ianhyzy/read-remote/FIRMWARE.md

# Read Remote firmware (ZMK)

ZMK config for the Seeed XIAO nRF52840 in the [case](../case/). Two direct-wired buttons, no matrix.

| key | wire | default |
|---|---|---|
| NEXT (big dished cap) | D0 ↔ GND | Page Down |
| PREV (small domed cap) | D1 ↔ GND | Page Up; **hold 5 s = power off** |
| both together | | **hold 1–4 s = travel lock on/off**; **hold 4 s+ = bootloader** |

KOReader turns pages on Page Down / Page Up out of the box. Most other reader apps do too.

## Get the firmware
GitHub Actions builds it on every push to `config/` or `build.yaml`. Open the latest run under **Actions**, download the `firmware` artifact, unzip to get `read_remote.uf2` (and `settings_reset.uf2`).

## Flash
1. Plug in USB-C. Hold **both buttons for 4 s or more**; a `XIAO-SENSE` drive appears. (Fallback, or on a blank board: double-press the reset button through the pinhole.)
2. Drag the `.uf2` onto it. The drive ejects itself and the remote reboots.

Pairings misbehaving? Flash the `settings_reset` artifact the same way, then flash `read_remote` again. That wipes all bonds.

## Pair
On the e-reader, Bluetooth settings → pair **Read Remote**. ZMK keeps up to 5 bonds; it reconnects to the last one.

## Travel lock
The case has a hard power switch (side slider) for travel; that is the normal way to stow it. The firmware lock remains as a backup: hold both buttons for 1–4 s and release, and the buttons are ignored until you do it again. The lock survives sleep and power off.

Why it matters: when the remote is awake and paired, every press sends a key, and a Bluetooth key press will usually wake the e-reader's screen and turn a page. After 30 min idle it deep-sleeps; the first press only wakes it (that press is lost, reconnect takes about a second), and every press after that turns pages again. Power off behaves the same way: any press wakes it. So without the lock, a jostled bag turns pages.

## Power
- Deep sleep after 30 min idle (`CONFIG_ZMK_IDLE_SLEEP_TIMEOUT`); any press wakes it, first press may be swallowed.
- Hold PREV 5 s: full power off. Press either button to wake.
- Battery level appears in the host's Bluetooth device details.

## Change the keymap
- **ZMK Studio** (no rebuild): plug in USB-C, open https://zmk.studio in Chrome, pick the device. Studio is enabled in `build.yaml`.
- Or edit `config/read_remote.keymap` and push; Actions rebuilds.

## Files
- `build.yaml` — which images to build (`read_remote` + `settings_reset`).
- `config/read_remote.keymap`, `config/read_remote.conf` — keymap and settings.
- `boards/shields/read_remote/` — the shield: pins, physical layout, metadata. `zephyr/module.yml` makes the repo a Zephyr module so ZMK finds it.
- `config/west.yml` — pins ZMK v0.3 (on `main` the board id changes to `xiao_ble//zmk`).
