ianhyzy/read-remote/case/renders/bars/base_iso.png

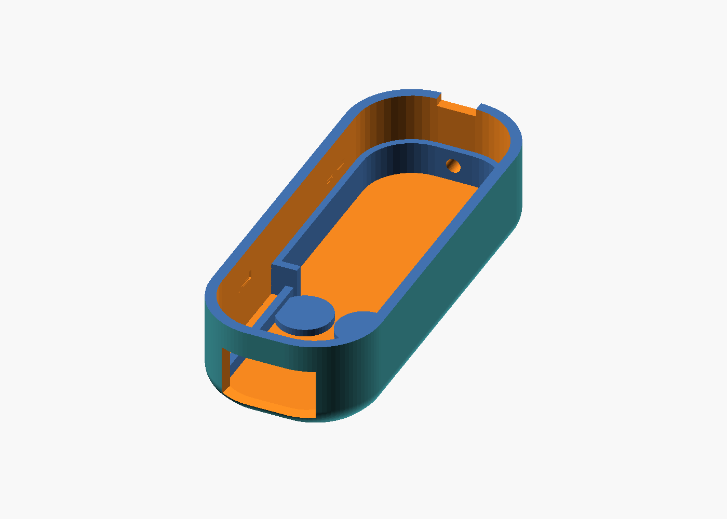
case/renders/bars/base_iso.png
