ianhyzy/read-remote/case/renders/bars/base_usb.png

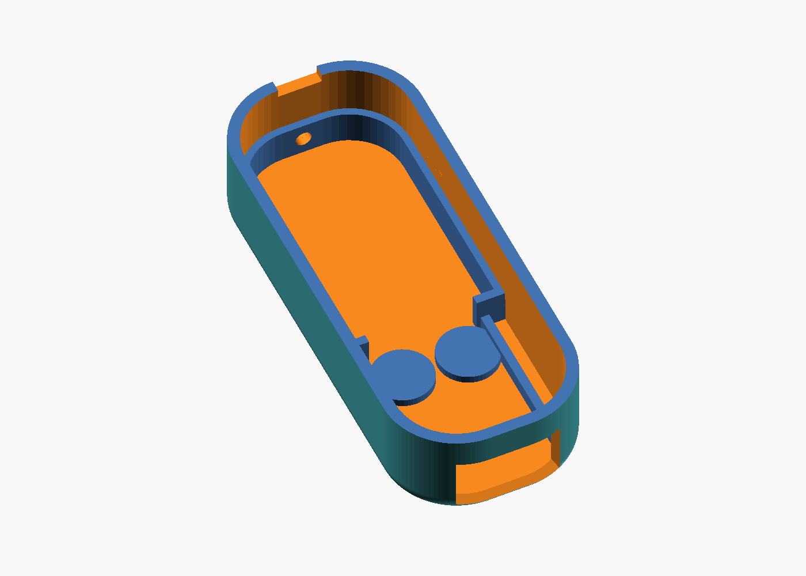
case/renders/bars/base_usb.png
