ianhyzy/read-remote/case/renders/bars/caps.png

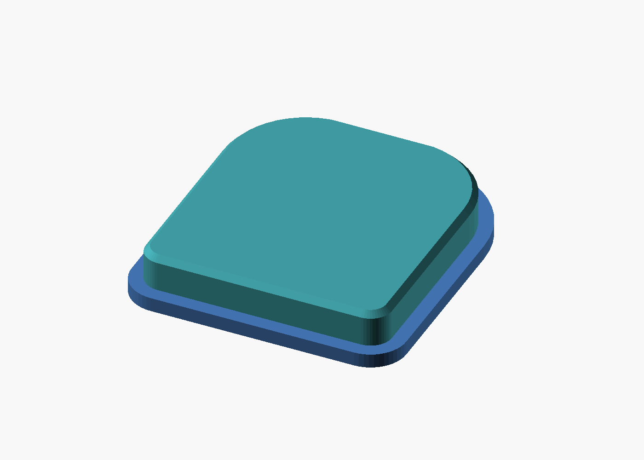
case/renders/bars/caps.png
