ianhyzy/read-remote/case/renders/bars/coupon.png

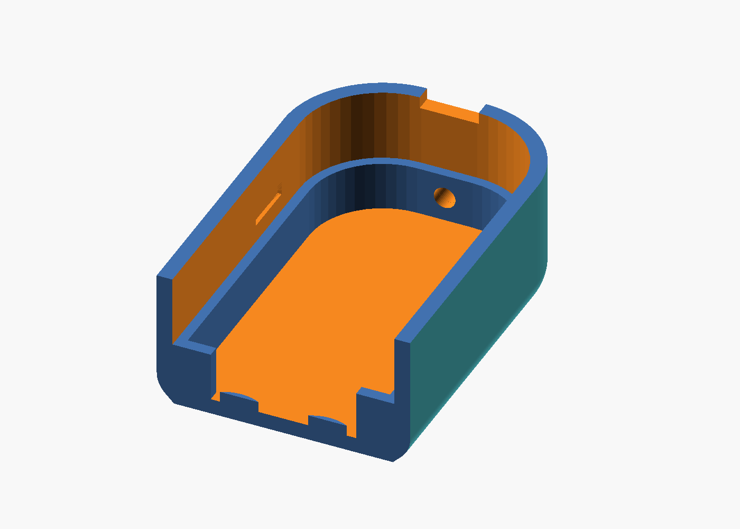
case/renders/bars/coupon.png
