ianhyzy/read-remote/case/renders/bars/exploded.png

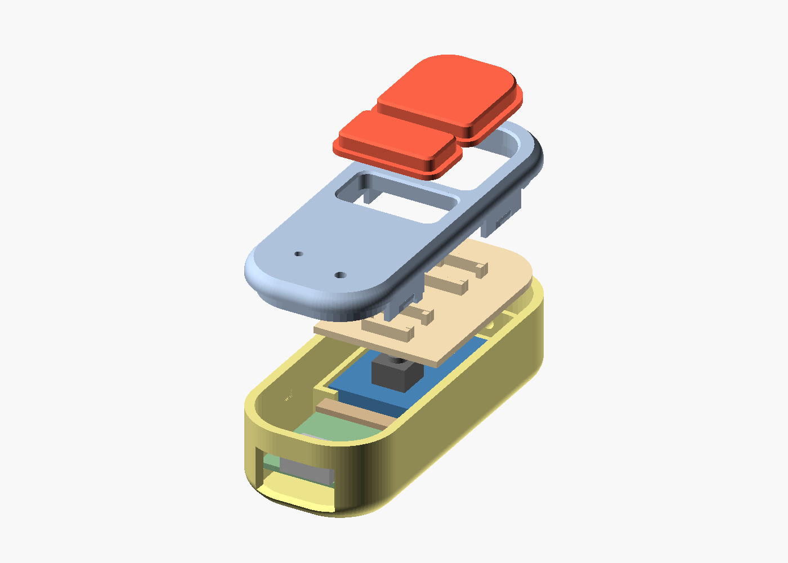
case/renders/bars/exploded.png
