ianhyzy/read-remote/case/renders/bars/lid_under.png

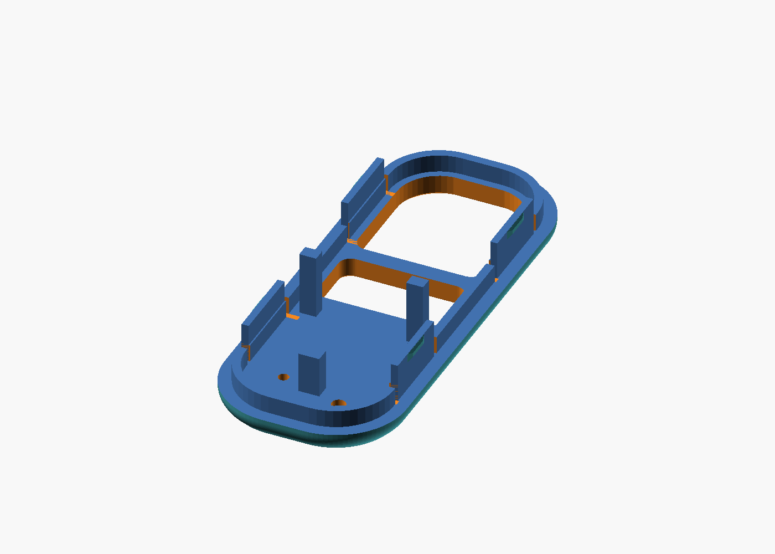
case/renders/bars/lid_under.png
