ianhyzy/read-remote/case/renders/bars/tray.png

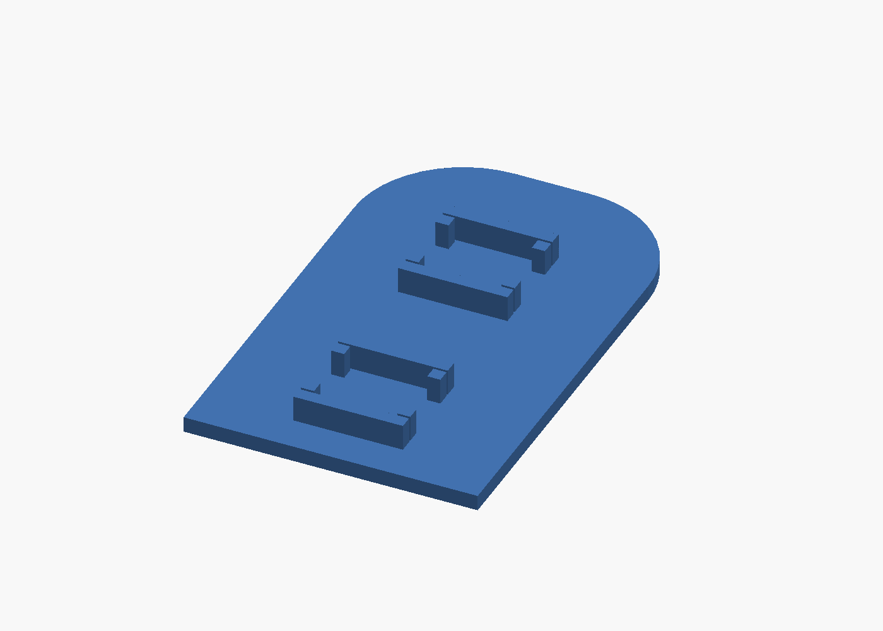
case/renders/bars/tray.png
