ianhyzy/read-remote/case/renders/bars/usb_end.png

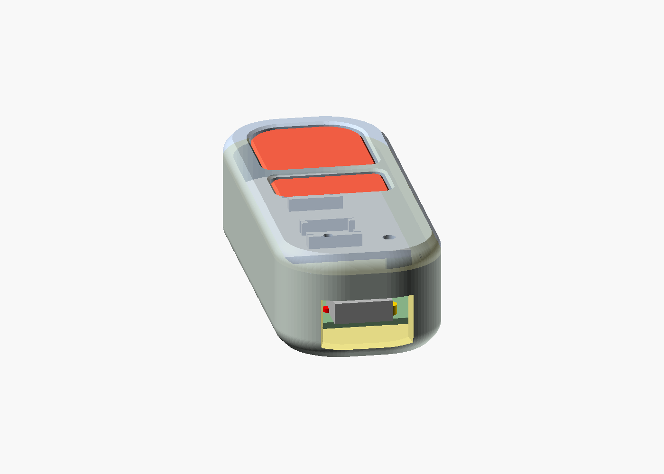
case/renders/bars/usb_end.png
