ianhyzy/read-remote/case/renders/concepts/channel_open.png

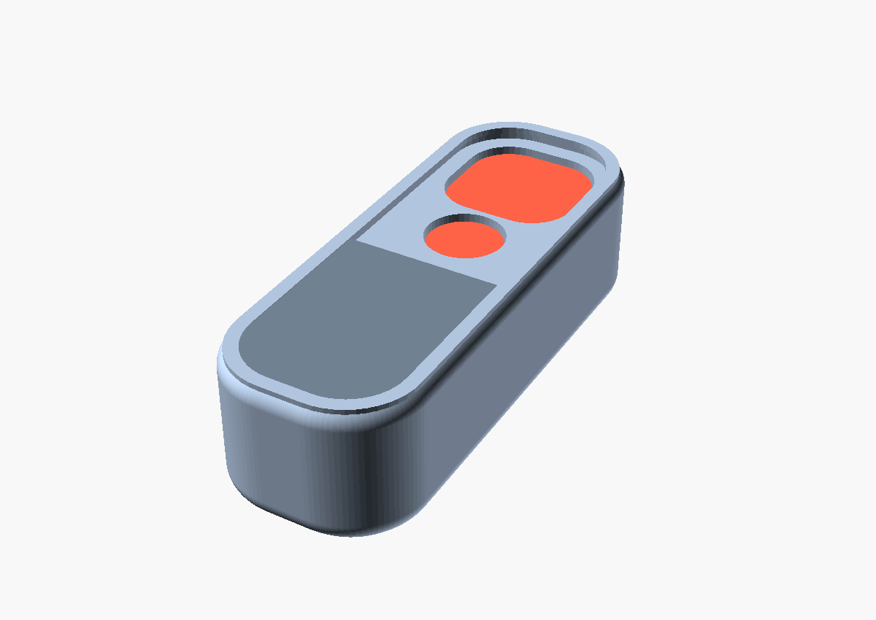
case/renders/concepts/channel_open.png
