ianhyzy/read-remote/case/renders/concepts/pencap_open.png

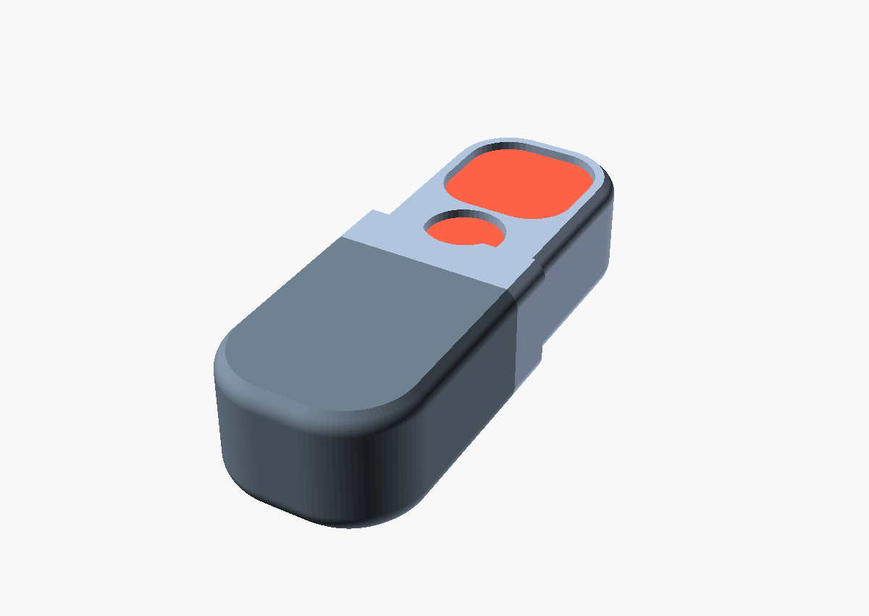
case/renders/concepts/pencap_open.png
