ianhyzy/read-remote/case/renders/dishdome/caps.png

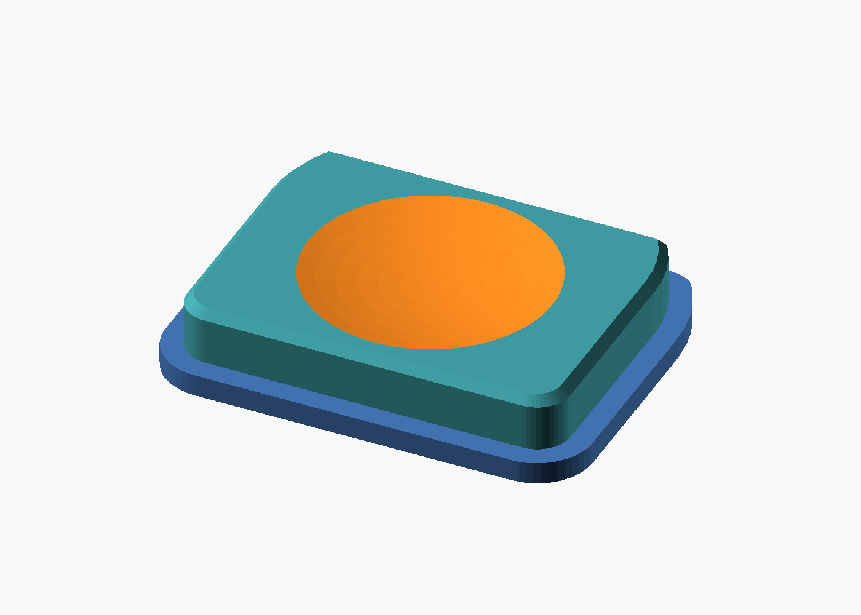
case/renders/dishdome/caps.png
