ianhyzy/read-remote/case/renders/kobo/caps.png

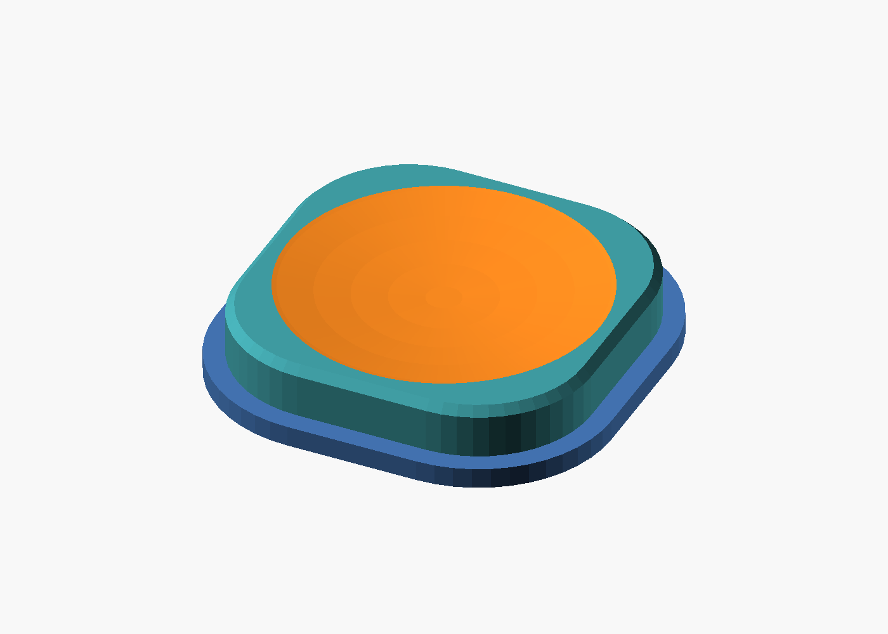
case/renders/kobo/caps.png
