ianhyzy/read-remote/case/renders/kobo/coupon_usb.png

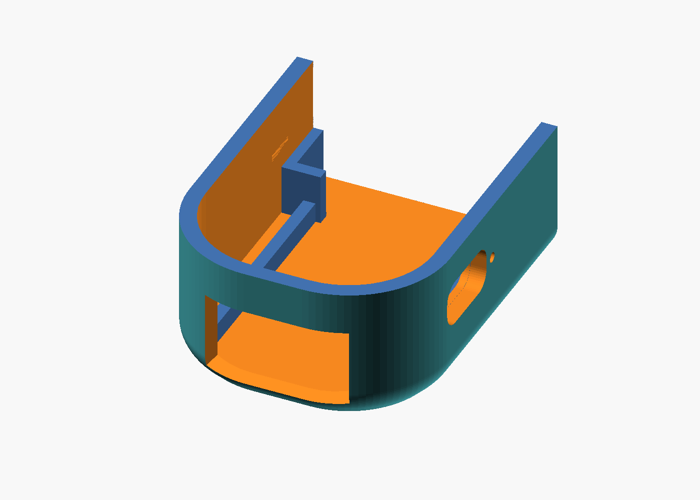
case/renders/kobo/coupon_usb.png
