ianhyzy/read-remote/case/renders/kobo/exploded.png

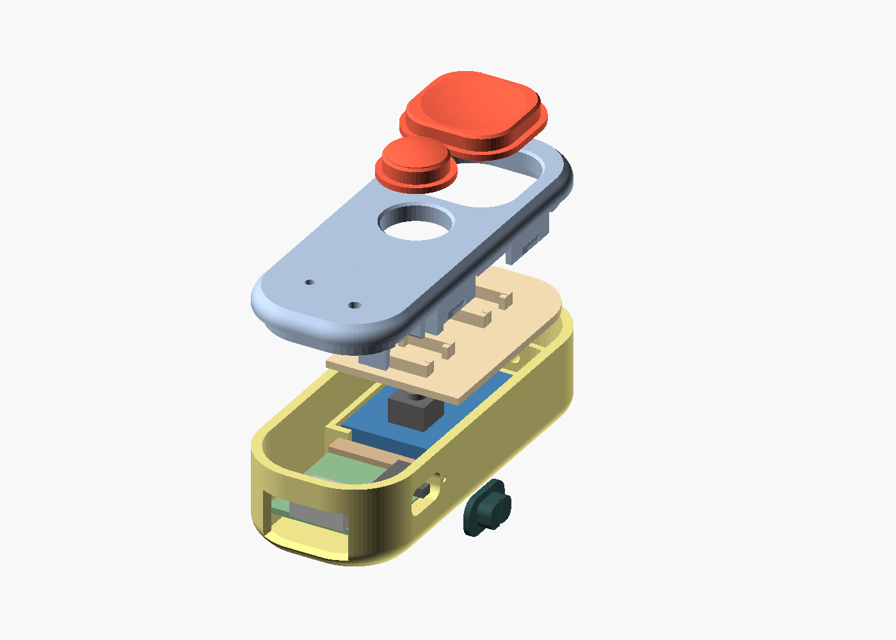
case/renders/kobo/exploded.png
