ianhyzy/read-remote/case/renders/kobo/knob.png

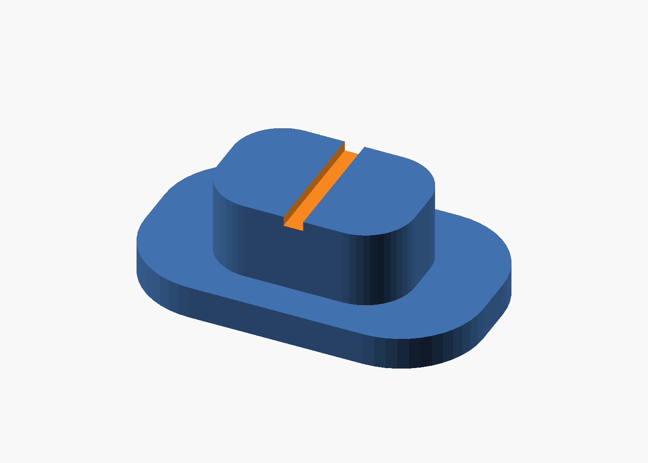
case/renders/kobo/knob.png
