ianhyzy/read-remote/case/renders/kobo/psw_lid.png

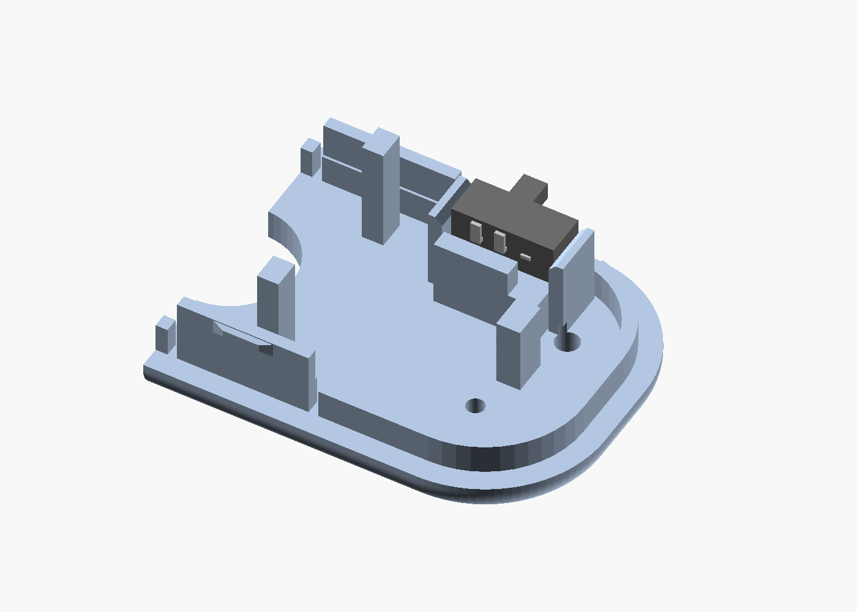
case/renders/kobo/psw_lid.png
