ianhyzy/read-remote/case/renders/kobo/psw_prep.png

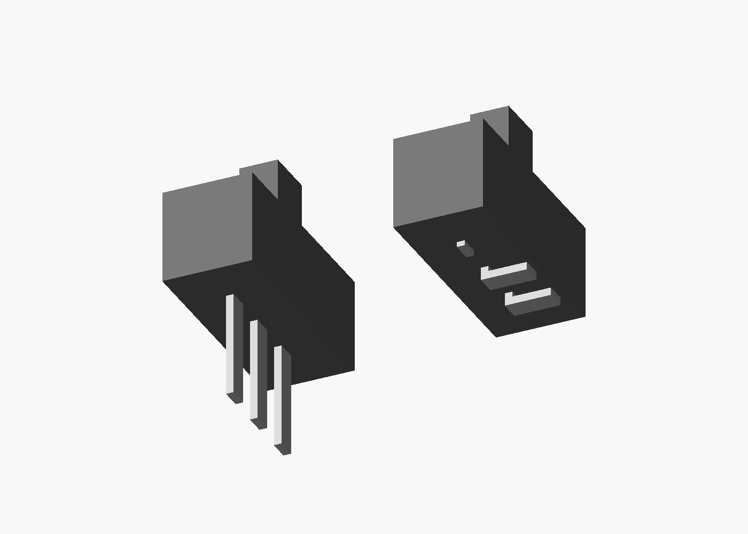
case/renders/kobo/psw_prep.png
