ianhyzy/read-remote/case/renders/kobo/side_iso.png

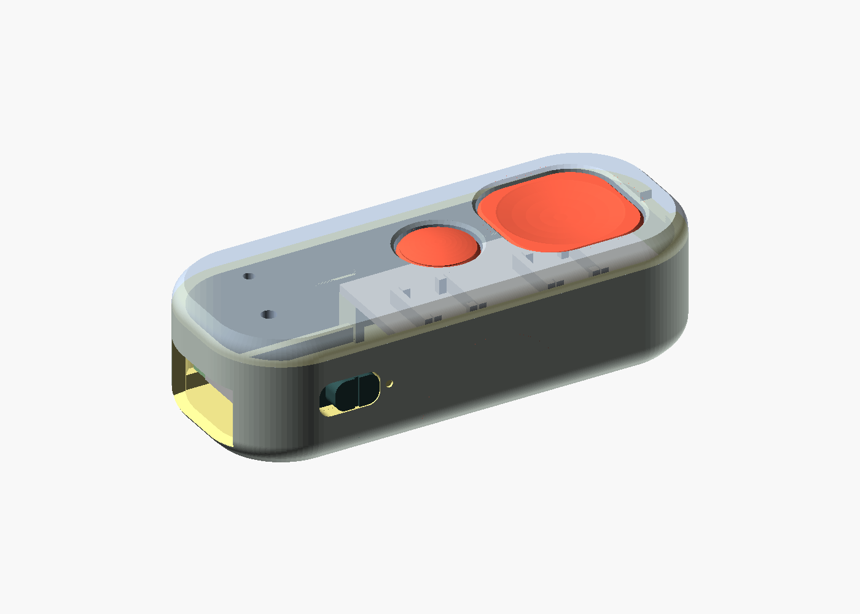
case/renders/kobo/side_iso.png
