ianhyzy/read-remote/case/renders/rocker/caps.png

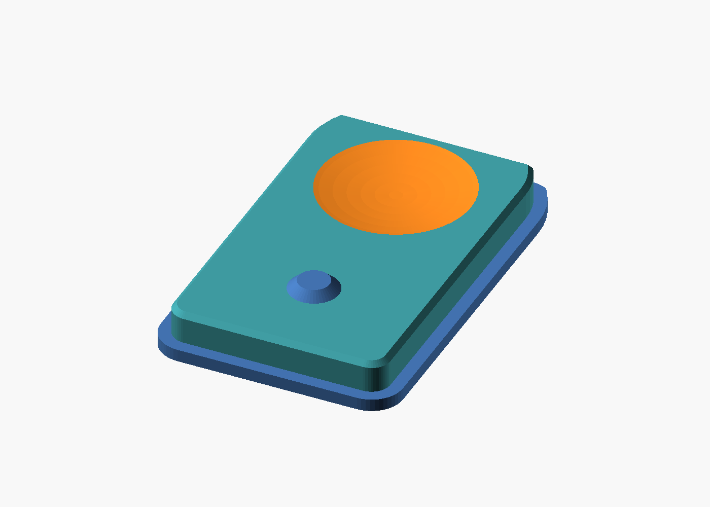
case/renders/rocker/caps.png
