ianhyzy/read-remote/case/renders/rocker/section_mag.png

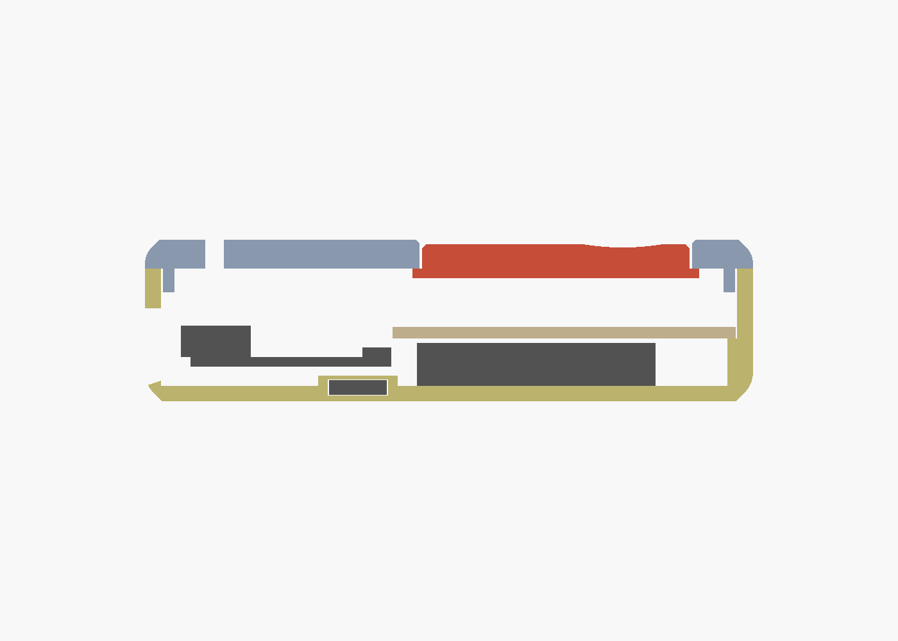
case/renders/rocker/section_mag.png
