ianhyzy/read-remote/case/renders/sidebyside/base_top.png

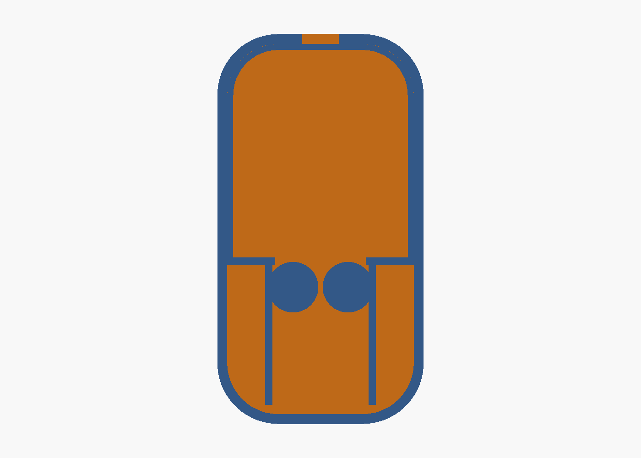
case/renders/sidebyside/base_top.png
