ianhyzy/read-remote/case/renders/sidebyside/base_usb.png

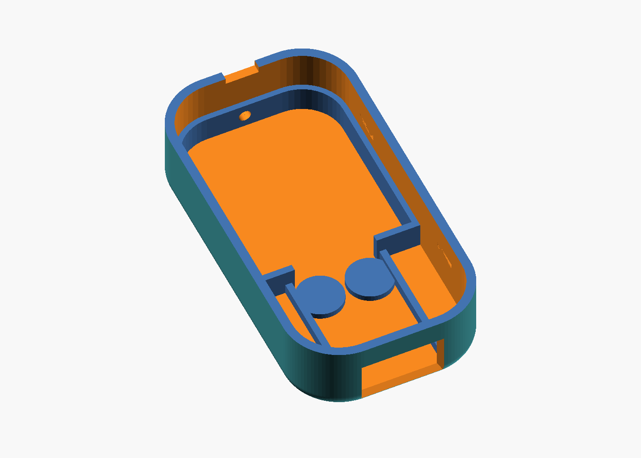
case/renders/sidebyside/base_usb.png
