ianhyzy/read-remote/case/renders/sidebyside/coupon.png

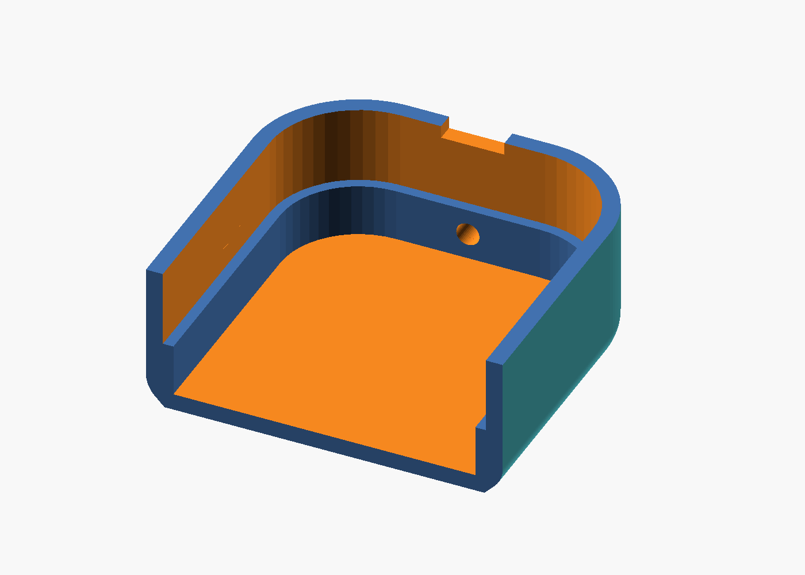
case/renders/sidebyside/coupon.png
