ianhyzy/read-remote/case/renders/sidebyside/exploded.png

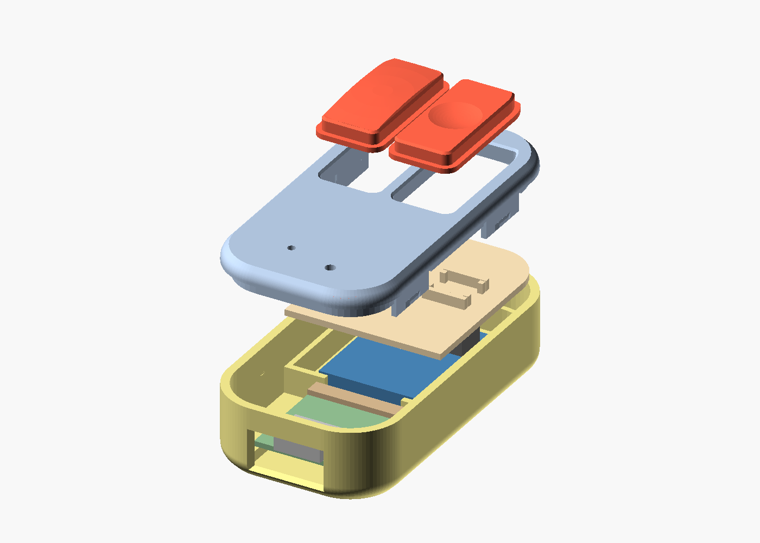
case/renders/sidebyside/exploded.png
