ianhyzy/read-remote/case/renders/sidebyside/lid_under.png

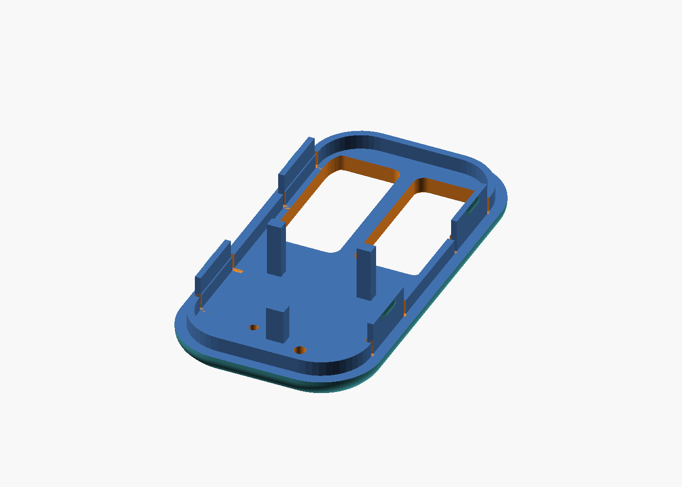
case/renders/sidebyside/lid_under.png
