ianhyzy/read-remote/case/renders/sidebyside/top.png

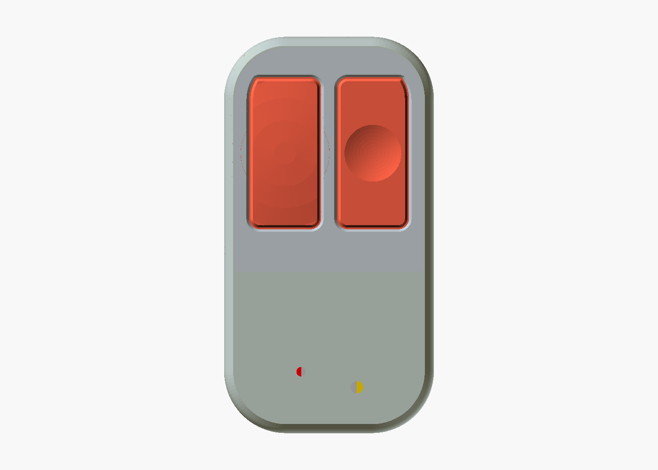
case/renders/sidebyside/top.png
