ianhyzy/read-remote/case/renders/sidebyside/tray.png

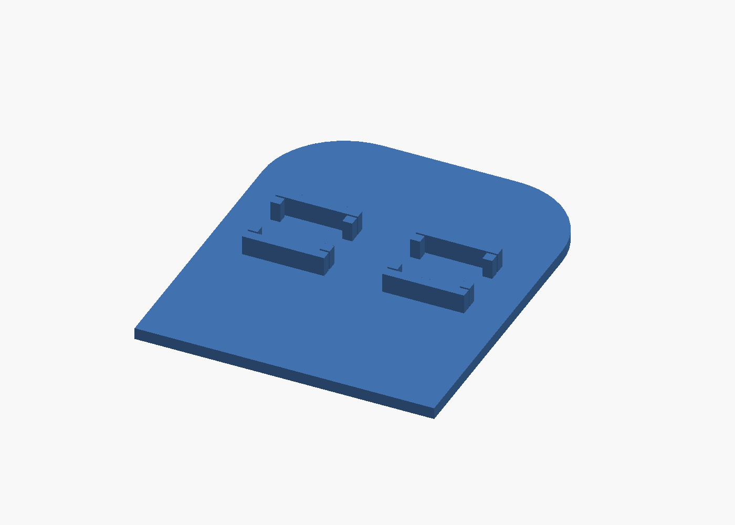
case/renders/sidebyside/tray.png
