ianhyzy/read-remote/case/renders/sidebyside/usb_end.png

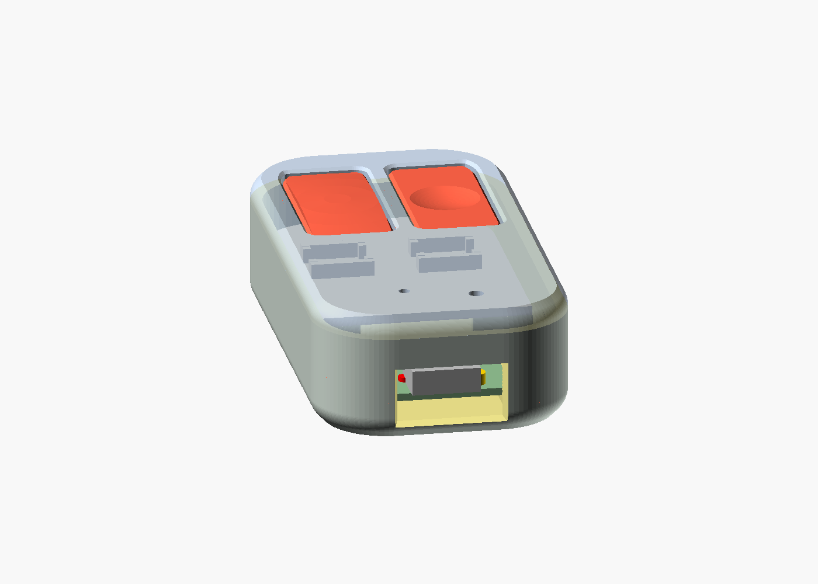
case/renders/sidebyside/usb_end.png
