ianhyzy/read-remote/case/stl/dishdome/coupon_base.stl

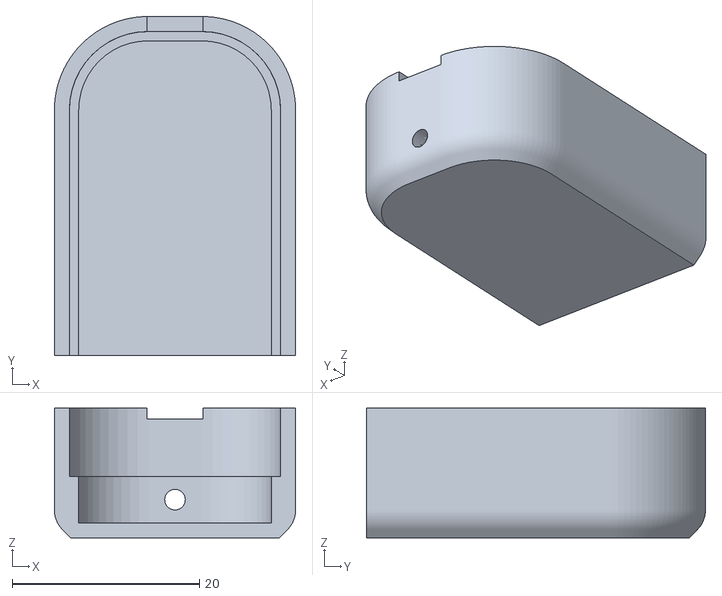
[picture p34: CAD file, 2026-10-19]
case/stl/dishdome/coupon_base.stl
25.8 x 36.2 x 13.9
