ianhyzy/read-remote/case/stl/dot/coupon_tray.stl

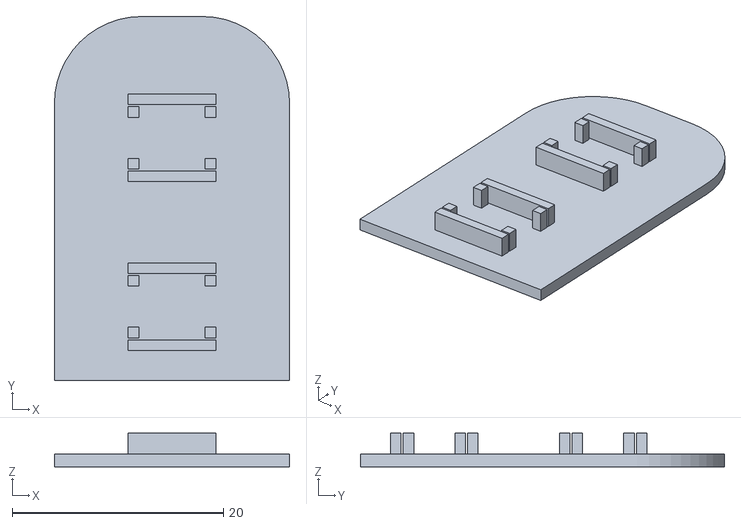
[picture p35: CAD file, 2026-10-19]
case/stl/dot/coupon_tray.stl
22.3 x 34.5 x 3.19
