ianhyzy/read-remote/case/stl/kobo/coupon_base.stl

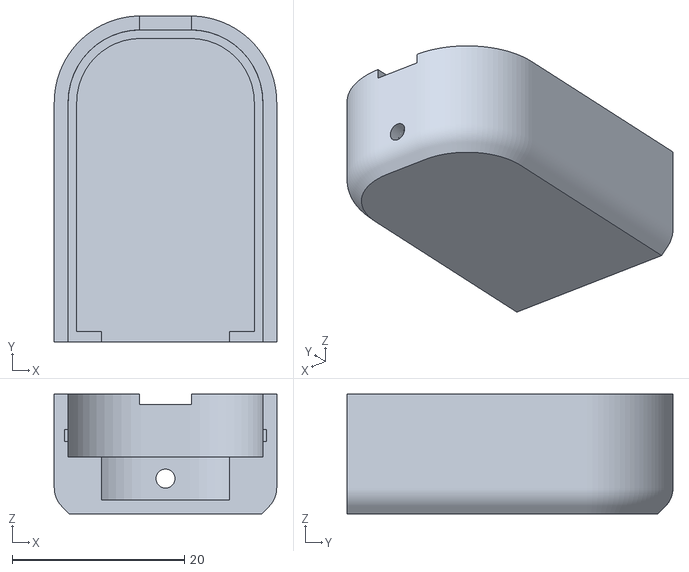
[picture p36: CAD file, 2026-10-31]
case/stl/kobo/coupon_base.stl
25.8 x 37.8 x 13.9
