ianhyzy/read-remote/case/stl/rocker/coupon_base.stl

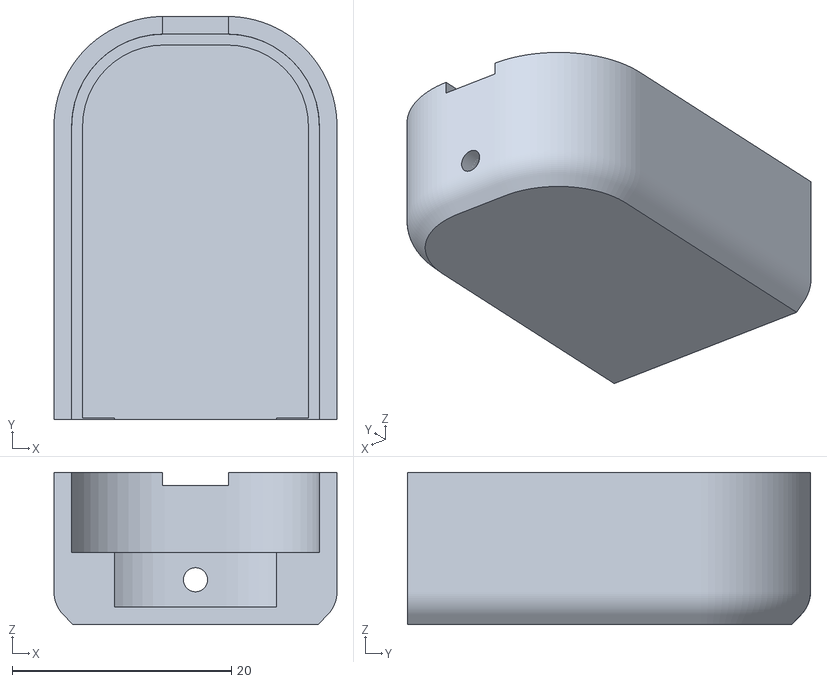
[picture p37: CAD file, 2026-10-19]
case/stl/rocker/coupon_base.stl
25.8 x 36.8 x 13.9
