ianhyzy/read-remote/case/stl/sidebyside/plunger_prev.stl

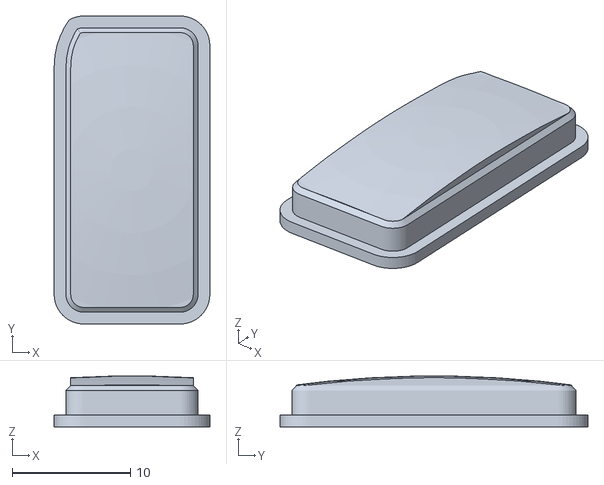
[picture p38: CAD file, 2026-10-19]
case/stl/sidebyside/plunger_prev.stl
13.1 x 26.0 x 4.28
