ianhyzy/read-remote/case/stl/dot/tray.stl

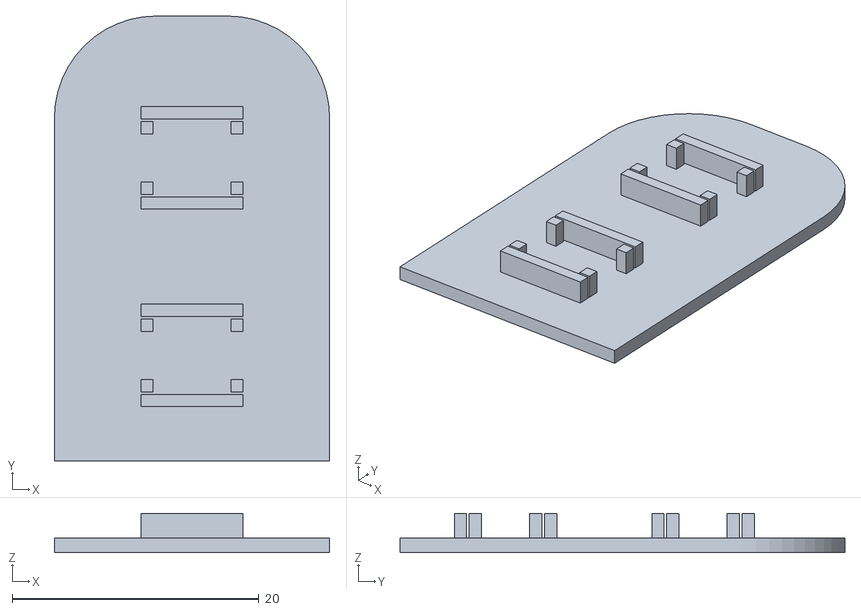
[picture p39: CAD file, 2026-10-19]
case/stl/dot/tray.stl
22.3 x 36.0 x 3.19
