ianhyzy/read-remote/case/stl/kobo/lid.stl

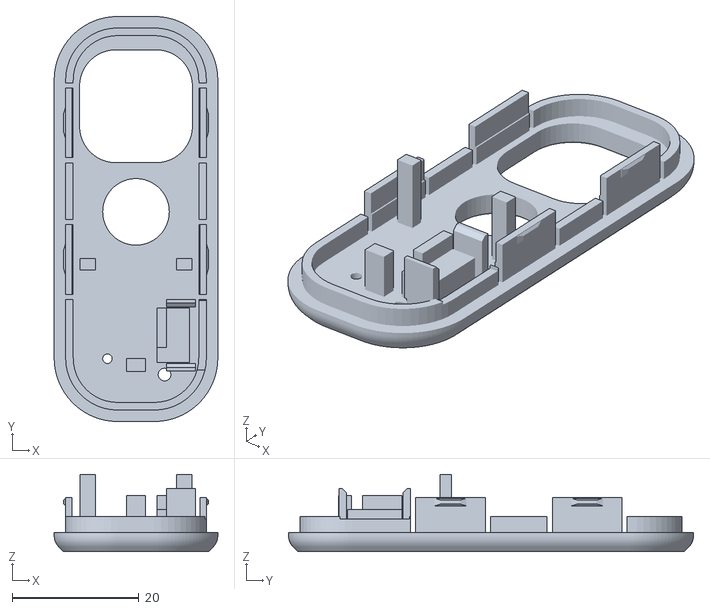
[picture p40: CAD file, 2026-10-31]
case/stl/kobo/lid.stl
25.8 x 63.9 x 12.1
