ianhyzy/read-remote/case/stl/rocker/coupon_lid.stl

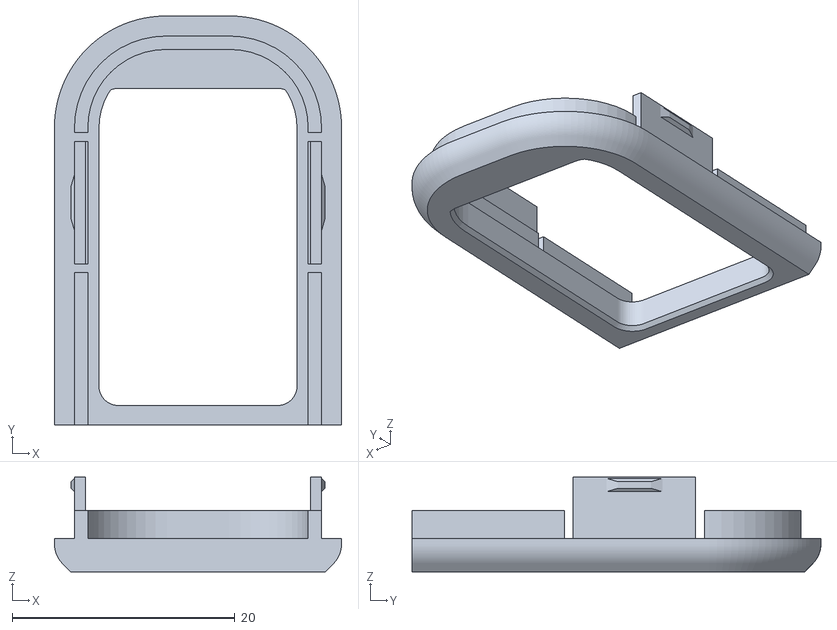
[picture p41: CAD file, 2026-10-19]
case/stl/rocker/coupon_lid.stl
25.8 x 36.8 x 8.50
