ianhyzy/read-remote/case/stl/sidebyside/coupon_lid.stl

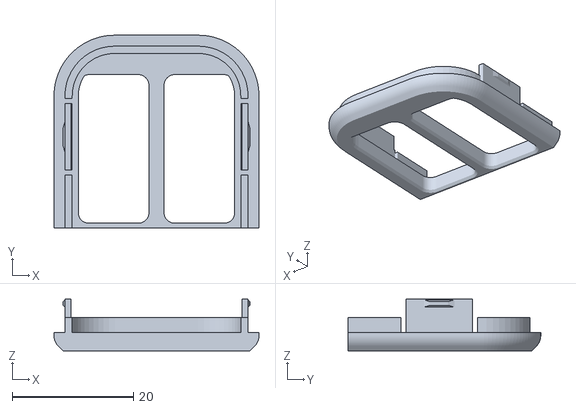
[picture p42: CAD file, 2026-10-19]
case/stl/sidebyside/coupon_lid.stl
33.8 x 31.8 x 8.50
