ianhyzy/read-remote/case/stl/dishdome/lid.stl

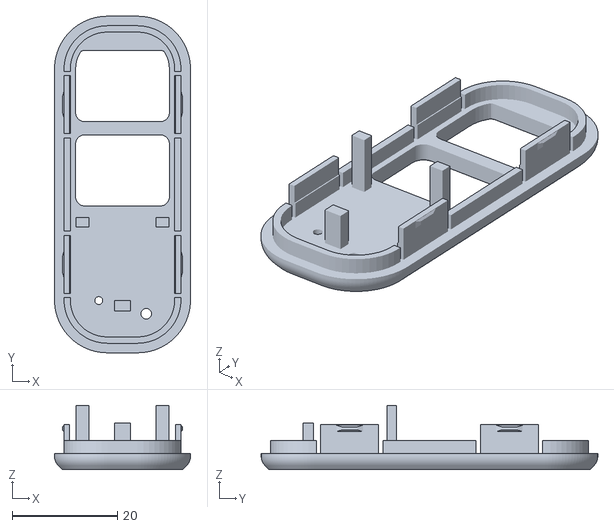
[picture p43: CAD file, 2026-10-19]
case/stl/dishdome/lid.stl
25.8 x 63.9 x 12.1
