ianhyzy/read-remote/case/stl/rocker/plunger_next.stl

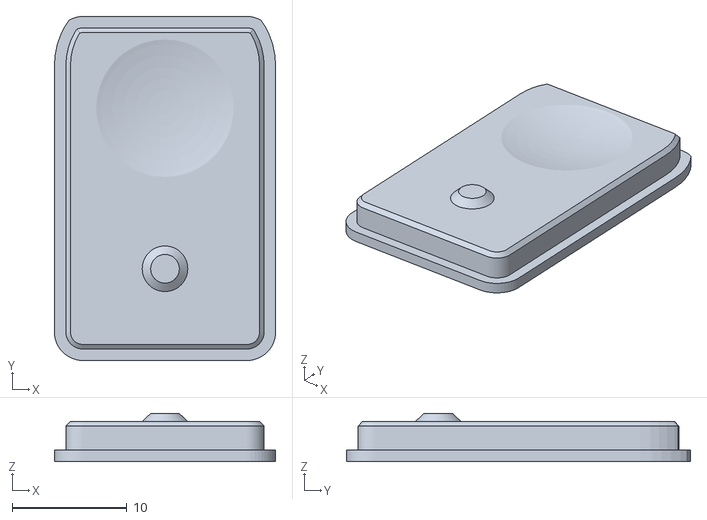
[picture p44: CAD file, 2026-10-19]
case/stl/rocker/plunger_next.stl
19.3 x 30.0 x 4.19
