ianhyzy/read-remote/case/stl/sidebyside/lid.stl

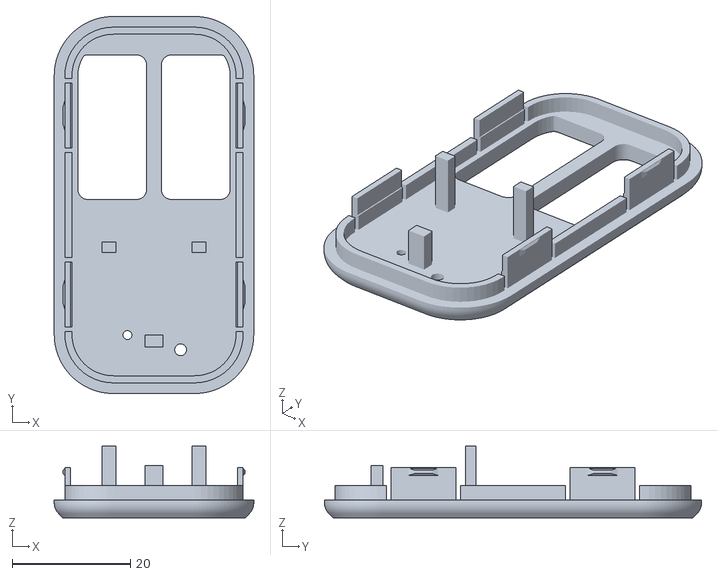
[picture p45: CAD file, 2026-10-19]
case/stl/sidebyside/lid.stl
33.8 x 63.9 x 12.1
