ianhyzy/read-remote/case/stl/dishdome/base.stl

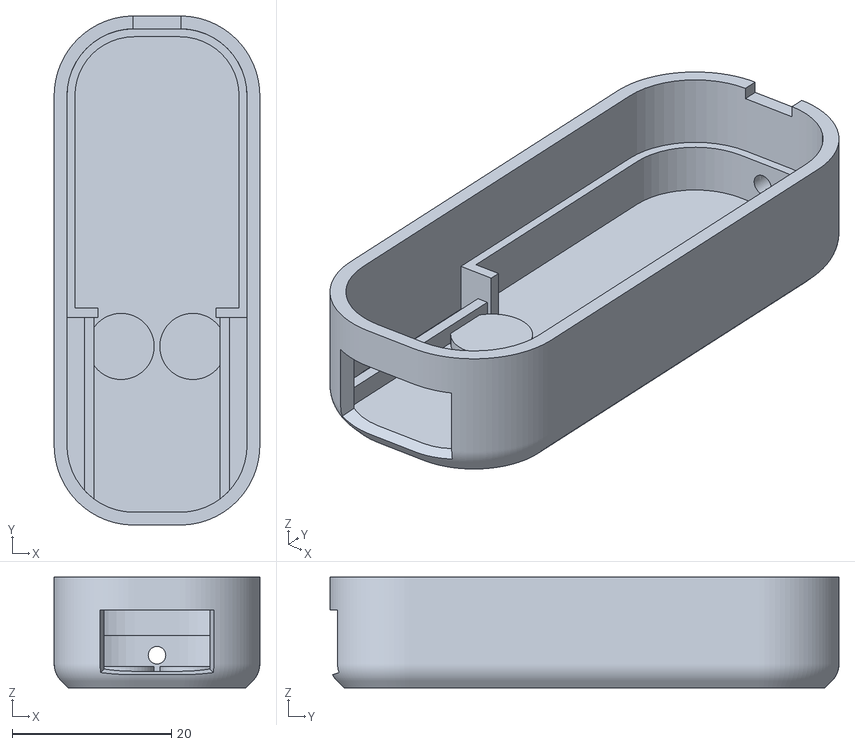
[picture p46: CAD file, 2026-10-19]
case/stl/dishdome/base.stl
25.8 x 63.9 x 13.9
