ianhyzy/read-remote/case/stl/dot/coupon_lid.stl

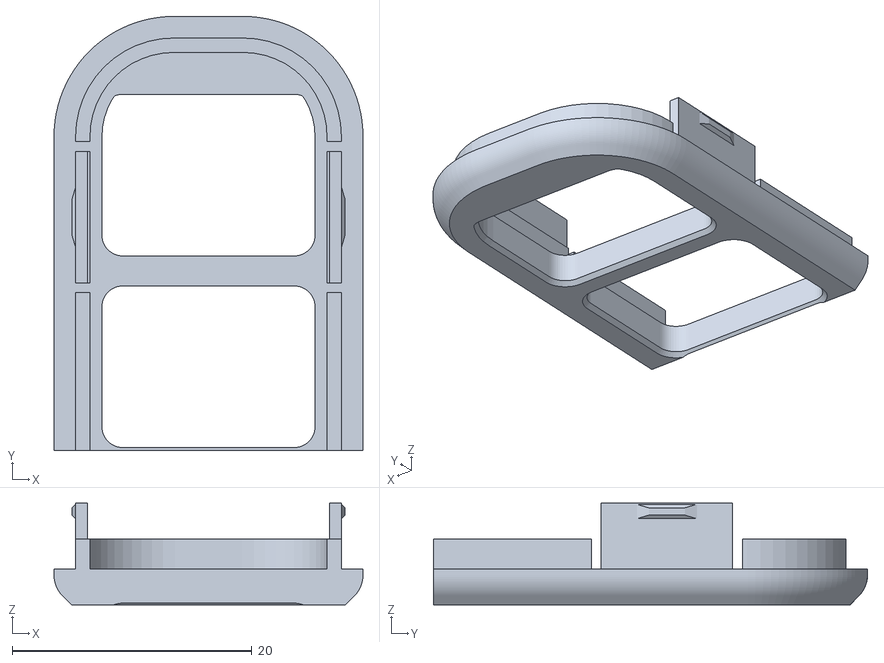
[picture p47: CAD file, 2026-10-19]
case/stl/dot/coupon_lid.stl
25.8 x 36.2 x 8.50
