ianhyzy/read-remote/case/stl/kobo/coupon_usb_lid.stl

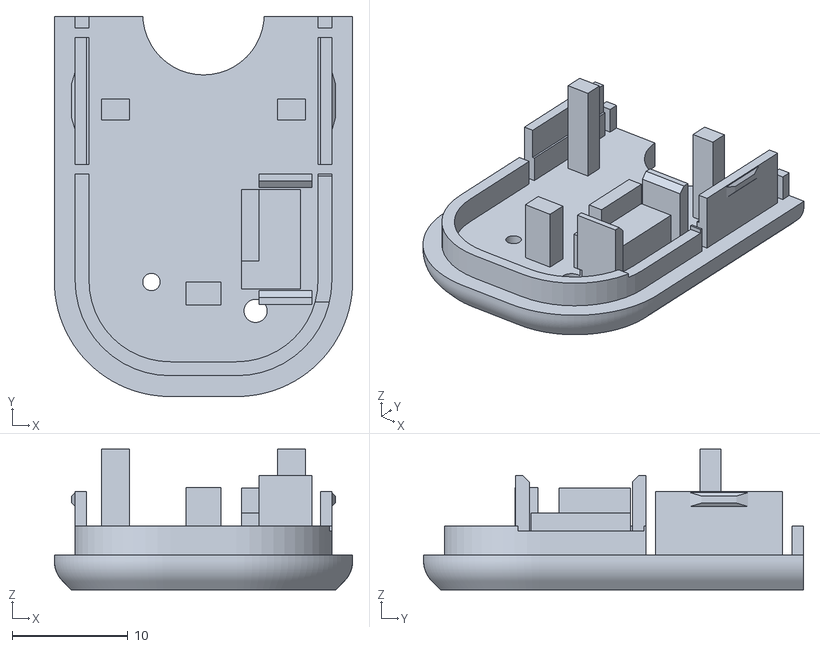
[picture p48: CAD file, 2026-10-31]
case/stl/kobo/coupon_usb_lid.stl
25.8 x 32.9 x 12.1
