ianhyzy/read-remote/case/stl/rocker/lid.stl

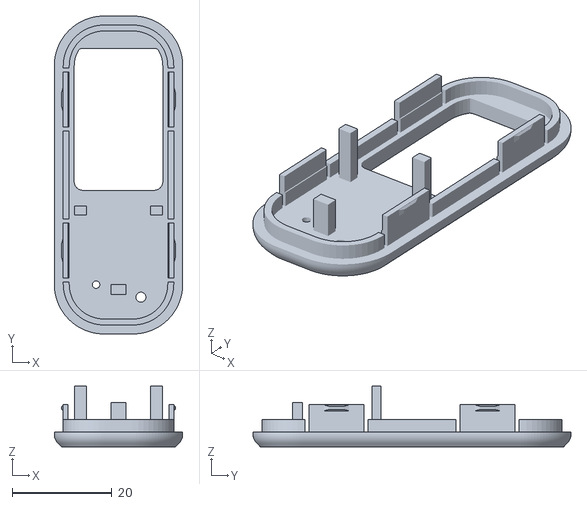
[picture p49: CAD file, 2026-10-19]
case/stl/rocker/lid.stl
25.8 x 63.9 x 12.1
