ianhyzy/read-remote/case/stl/sidebyside/coupon_tray.stl

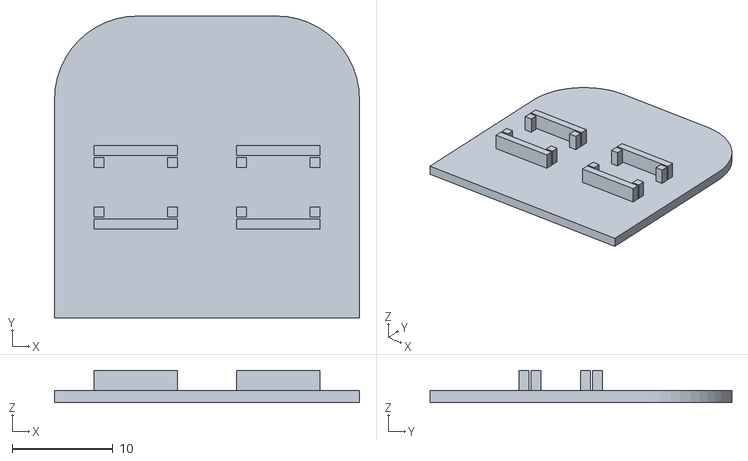
[picture p50: CAD file, 2026-10-19]
case/stl/sidebyside/coupon_tray.stl
30.3 x 30.0 x 3.19
