ianhyzy/read-remote/case/stl/dishdome/plunger_next.stl

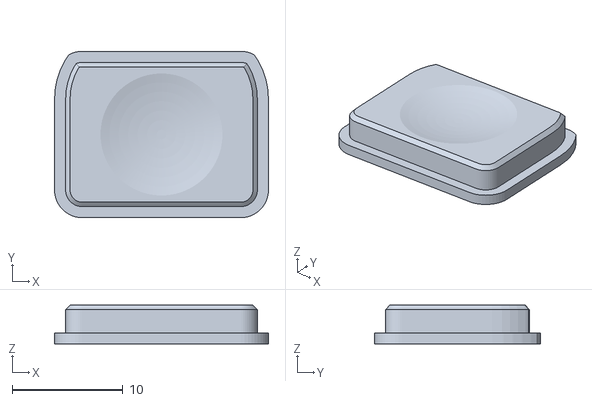
[picture p51: CAD file, 2026-10-19]
case/stl/dishdome/plunger_next.stl
19.3 x 15.0 x 3.50
