ianhyzy/read-remote/case/stl/kobo/coupon_usb_base.stl

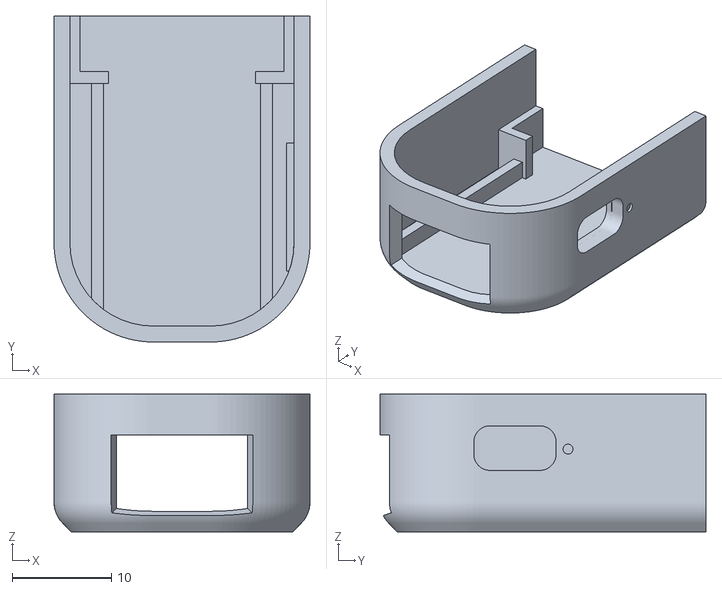
[picture p52: CAD file, 2026-10-31]
case/stl/kobo/coupon_usb_base.stl
25.8 x 32.9 x 13.9
