ianhyzy/read-remote/case/stl/rocker/coupon_tray.stl

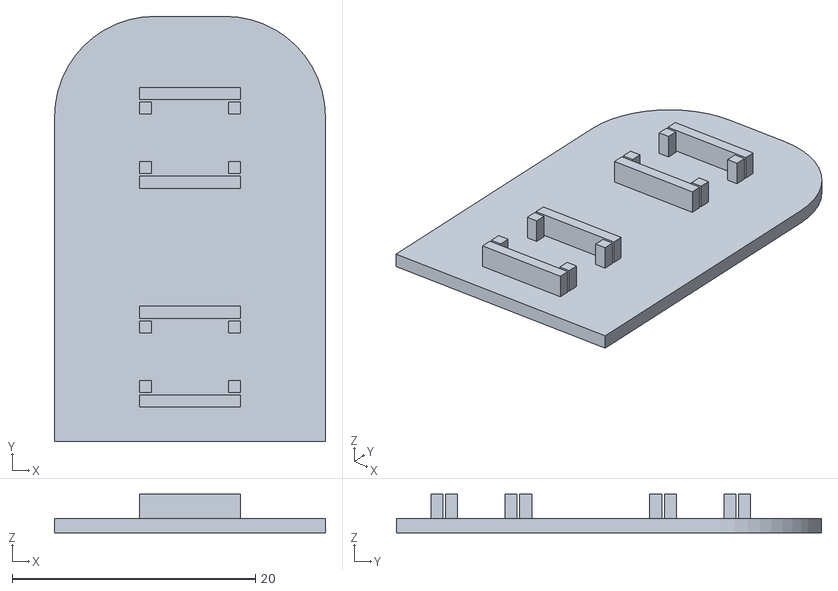
[picture p53: CAD file, 2026-10-19]
case/stl/rocker/coupon_tray.stl
22.3 x 35.0 x 3.19
