ianhyzy/read-remote/case/stl/sidebyside/plunger_next.stl

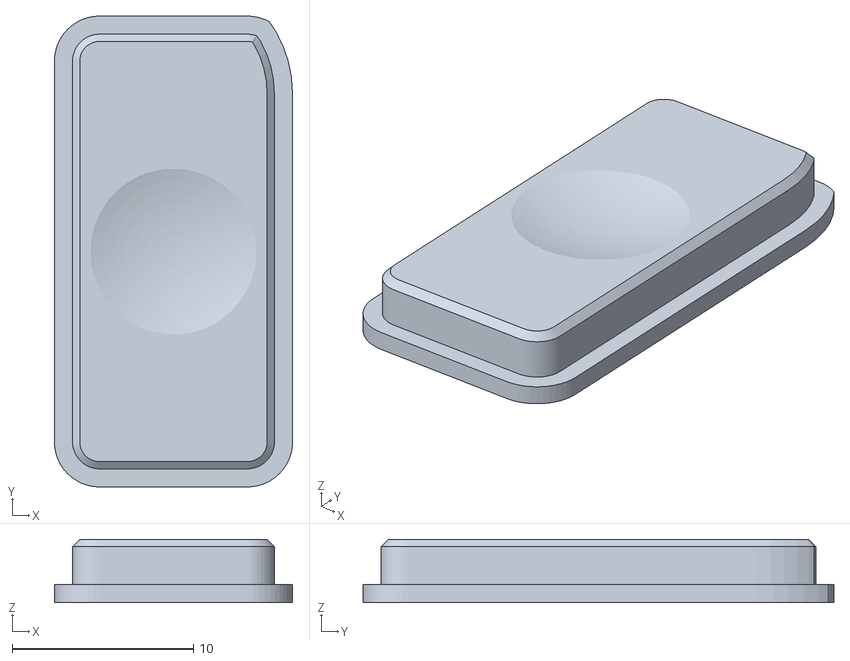
[picture p54: CAD file, 2026-10-19]
case/stl/sidebyside/plunger_next.stl
13.1 x 26.0 x 3.50
