ianhyzy/read-remote/case/stl/sidebyside/tray.stl

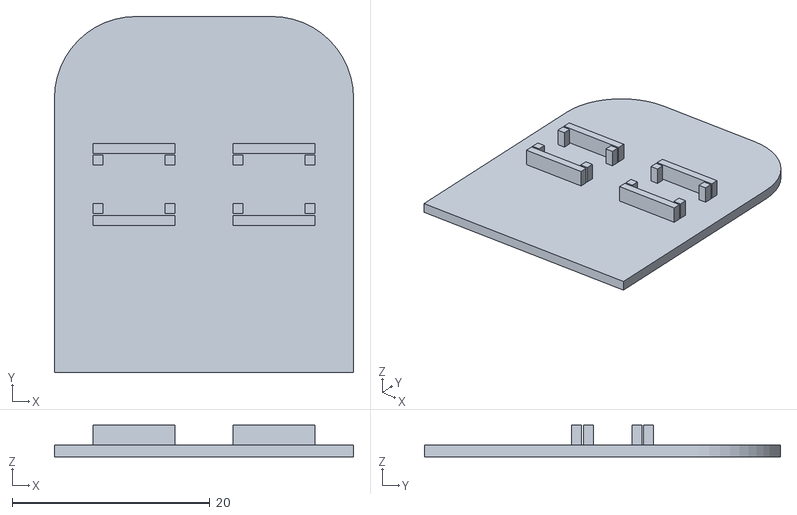
[picture p55: CAD file, 2026-10-19]
case/stl/sidebyside/tray.stl
30.3 x 36.0 x 3.19
