ianhyzy/read-remote/case/stl/kobo/coupon_lid.stl

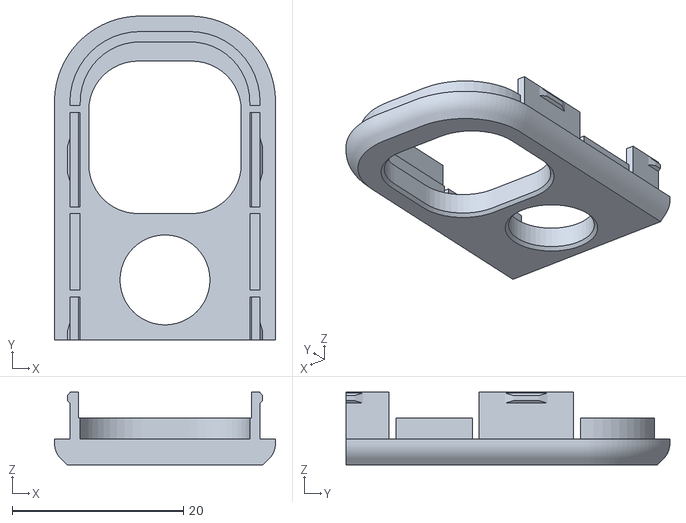
[picture p56: CAD file, 2026-10-31]
case/stl/kobo/coupon_lid.stl
25.8 x 37.8 x 8.50
