ianhyzy/read-remote/case/stl/sidebyside/base.stl

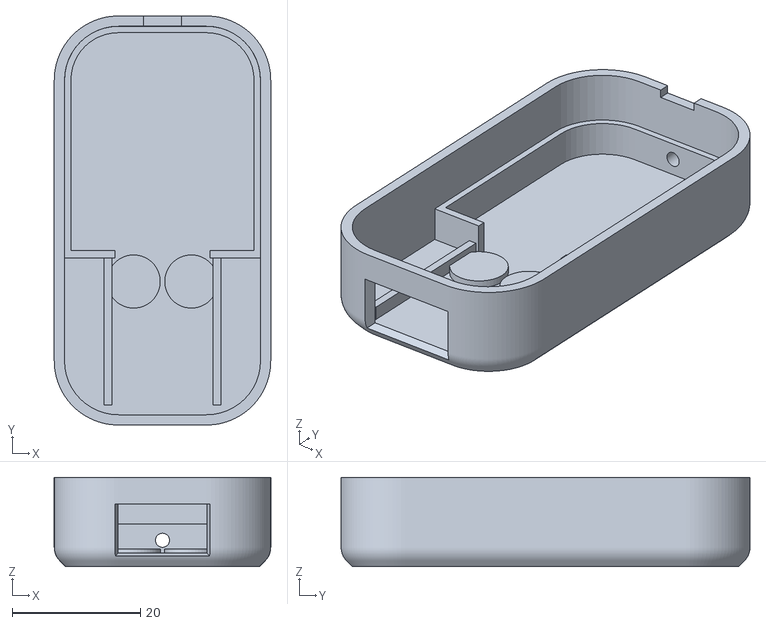
[picture p57: CAD file, 2026-10-19]
case/stl/sidebyside/base.stl
33.8 x 63.9 x 13.9
