ianhyzy/read-remote/case/stl/dishdome/plunger_prev.stl

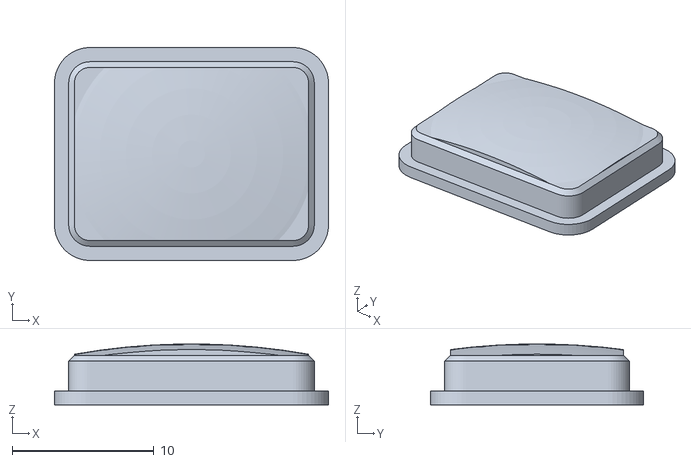
[picture p58: CAD file, 2026-10-19]
case/stl/dishdome/plunger_prev.stl
19.3 x 15.0 x 4.29
