ianhyzy/read-remote/case/stl/dot/plunger_prev.stl

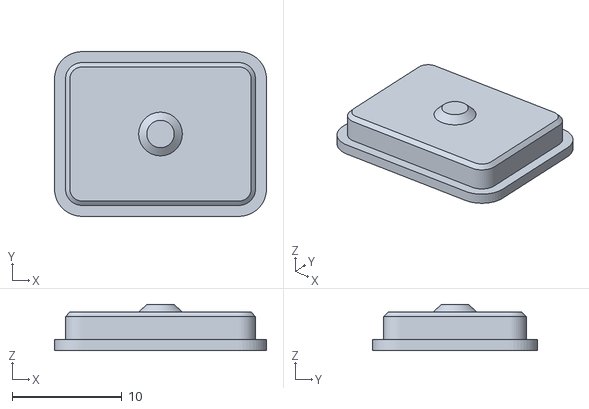
[picture p59: CAD file, 2026-10-19]
case/stl/dot/plunger_prev.stl
19.3 x 15.0 x 4.19
