ianhyzy/read-remote/case/stl/sidebyside/coupon_base.stl

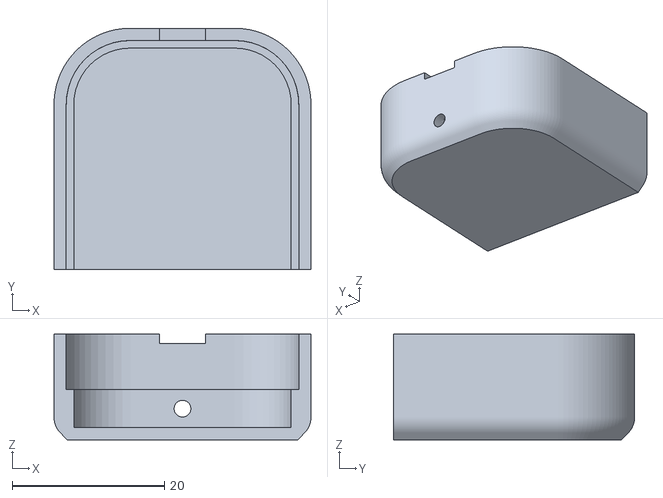
[picture p60: CAD file, 2026-10-19]
case/stl/sidebyside/coupon_base.stl
33.8 x 31.8 x 13.9
