ianhyzy/read-remote/case/stl/kobo/knob.stl

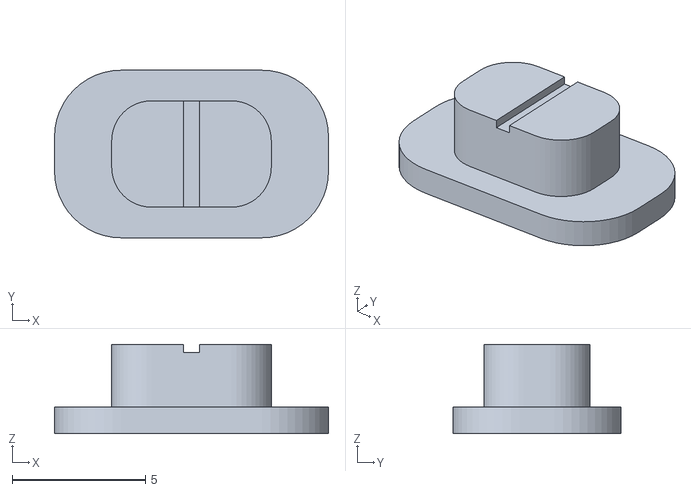
[picture p61: CAD file, 2026-10-19]
case/stl/kobo/knob.stl
10.3 x 6.30 x 3.35
