ianhyzy/read-remote/case/stl/kobo/plunger_next.stl

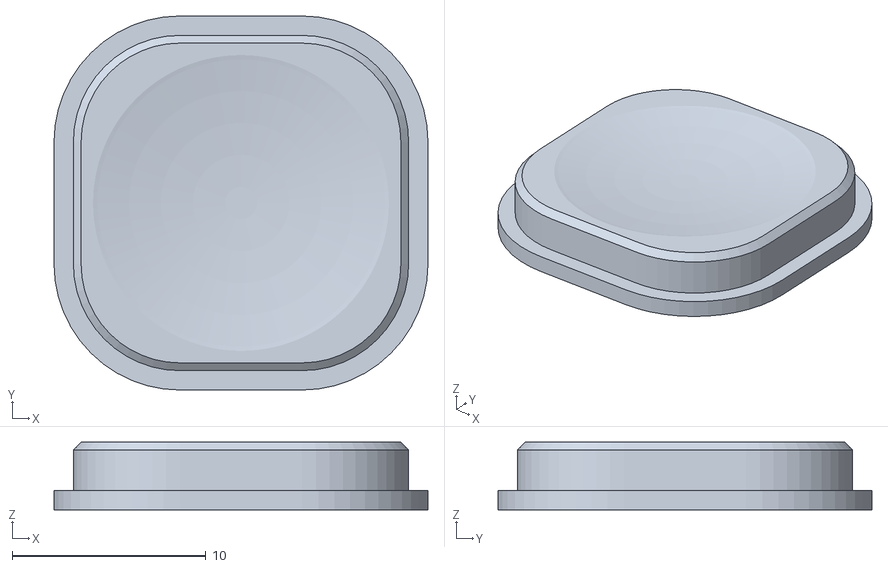
[picture p62: CAD file, 2026-10-19]
case/stl/kobo/plunger_next.stl
19.3 x 19.3 x 3.50
