ianhyzy/read-remote/case/stl/kobo/plunger_prev.stl

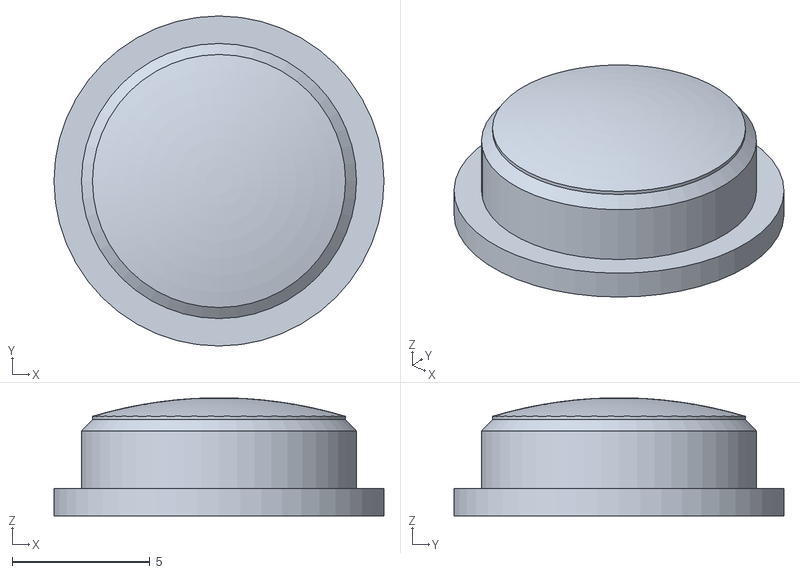
[picture p63: CAD file, 2026-10-18]
case/stl/kobo/plunger_prev.stl
12.0 x 12.0 x 4.29
