ianhyzy/read-remote/(list of files, cad)

Other CAD files:
case/stl/kobo/tray.stl
case/stl/kobo/coupon_tray.stl
case/stl/rocker/tray.stl
case/stl/dot/plunger_next.stl
case/stl/kobo/base.stl
