ianhyzy/read-remote/guide/index.html

# Read Remote Build Guide

## Parts and tools

### Parts

- Seeed XIAO nRF52840
- 402025 LiPo, 150 mAh, with protection board
- 2 × 6×6×5 mm silent tact switch, silicone top
- SS12D00G3 slide switch
- 28–30 AWG stranded wire
- Kapton tape, solder

### Tools

- Fine-tip iron, flux
- Flush cutters, tweezers, wire strippers
- Multimeter with continuity beep
- Calipers
- CA glue

LiPo safety. Never let the two battery leads touch. Cut and strip them one at a time and tape each end before touching the other. Keep the iron away from the pouch.

## Measure before printing

Caliper your parts, change case/params.scad where they differ, run ./render.sh kobo.

Param | Measure | Nominal
sw_h | Tact switch, base to top of the silicone dome, unpressed. Get this to 0.05 mm: the switch only travels 0.25 mm. | 5.0
batt | Battery width × length × thickness, including the protection-board bump and tape | 20 × 25 × 4.5
psw | Slide switch body: length × depth (handle to pins) × height | 8.6 × 3.6 × 3.5
psw_handle | Handle: along the slide × across × length past the body | 2.0 × 1.5 × 3.0
usb_plug | Your bulkiest USB-C plug body, W × H, plus 1 mm | 12.5 × 7.0
xiao | Board width × length × thickness | 17.8 × 21 × 1.0

## Print

Bambu P1S, PLA, 0.4 mm nozzle. STLs are in case/stl/kobo/.

Setting | Value
Layer height | 0.12 mm
Walls | 3
Supports | Off
Plate | Smooth PEI or cool plate. The lid prints top-face down, so a textured plate would texture the top.
Ironing | Off

### First, the fit coupon

Print coupon_base, coupon_lid, coupon_tray, coupon_usb_base, coupon_usb_lid, both caps and one knob.

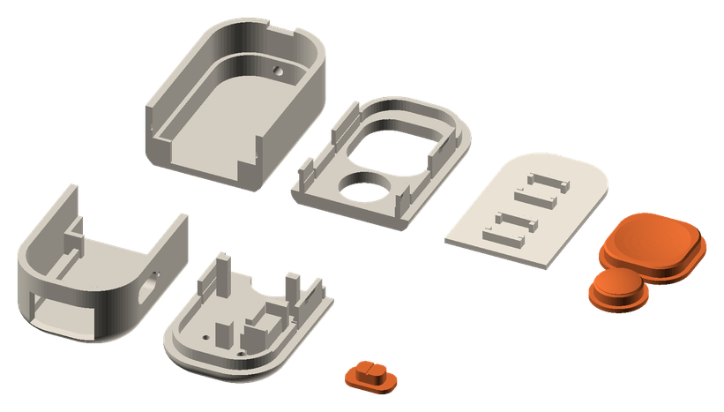
[picture p64: guide/img/coupon.png]
Coupon parts: button-end base, lid and tray, USB-end base and lid, two caps, knob


- Tact switches drop into the tray pockets without rocking.
- Coupon lid snaps onto the coupon base and comes off with a fingernail in the notch.
- With switches, tray and caps inside, each cap clicks once, returns, and does not rattle or stay pressed.
- The knob pushes onto the slide switch handle firmly and does not wobble.
- In the USB-end base: knob through the window from inside, switch pressed onto it, lid snapped on. The knob slides end to end with a clean click at each end and sits flush with the wall. With the lid off, the switch does not slip off the handle when nudged.

If anything is off, see Fixes, change the param, re-export, and reprint just that part.

### Then the full set

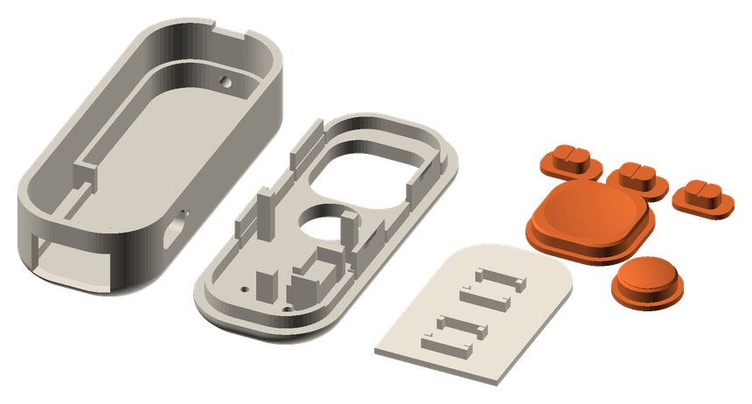
[picture p65: guide/img/plate.png]
All printed parts on the build plate in print orientation


Part | Qty
base | 1
lid | 1
tray | 1
plunger_next | 1
plunger_prev | 1
knob | 3

## Flash and test the bare board

1. Download the latest firmware artifact from the repo's Actions page (https://github.com/ianhyzy/read-remote/actions) and unzip it. You need read_remote.uf2.
2. Plug the XIAO into your computer and double-press its reset button. A drive called XIAO-SENSE appears.
3. Drag read_remote.uf2 onto the drive. It ejects itself and the board reboots.
4. On the e-reader, pair Read Remote in Bluetooth settings.
5. Touch tweezers across D0 and GND: the page turns forward. D1 to GND turns back.

## Wiring

From | To | Length
NEXT switch, leg A | D0 | 60 mm
PREV switch, leg A | D1 | 60 mm
NEXT leg B | PREV leg B | 25 mm
PREV leg B | GND (pin 2 on the 5V side) | 70 mm
Battery red | Slide switch COM (middle pin) | battery lead
Slide switch ON pin | BAT+, underside | 50 mm
Battery black | BAT−, underside | battery lead

Cut long, trim at assembly. The D0/D1 side of the board is the side the slide switch sits on in the case; GND is on the opposite side. The battery pads are labelled on the underside silkscreen; go by the labels, not by the diagram's positions.

## Solder on the bench

### Tact switches on the tray

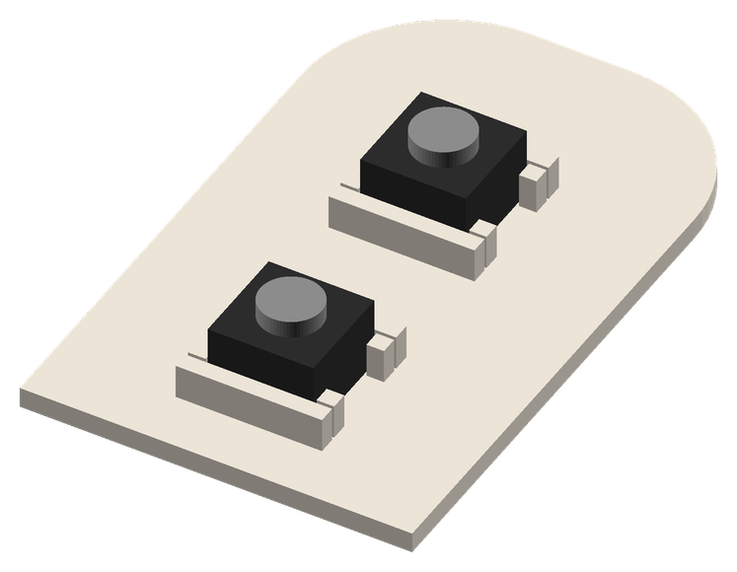
[picture p66: guide/img/tray_sw.png]
Tray with two tact switches in their pockets


- Drop each switch into its pocket, legs toward the open sides. With four legs, use two diagonally opposite ones. A meter should beep across them only while pressed.
- Solder a 60 mm signal wire to one leg of each switch. Mark which is NEXT (the far, big-cap position) and which is PREV.
- Join the other legs with a short jumper, then add one 70 mm ground wire from PREV.

### Slide switch

The switch lies on its side in the case, handle out through the wall. Its pins have only 1 mm of room before a wall on the lid, so they get clipped short and folded flat against the switch. Straight pins hit that wall and the switch won't sit flat.

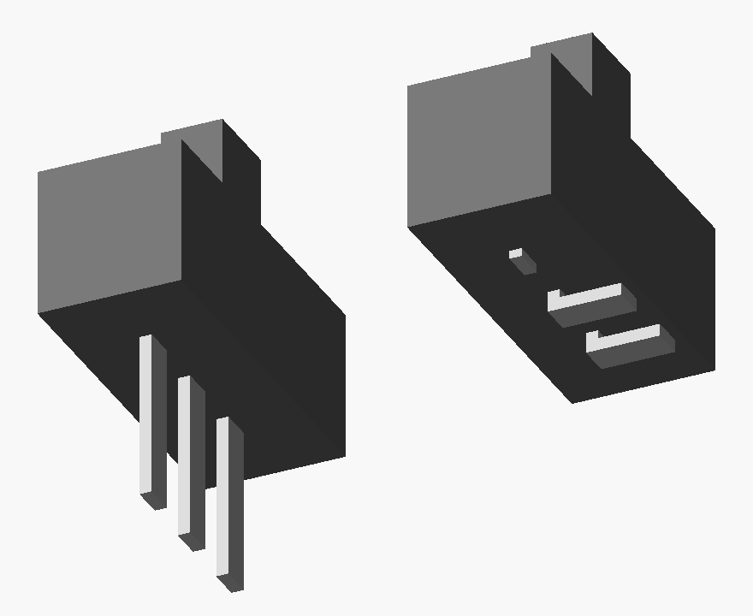
[picture p67: guide/img/psw_prep.png]
Two slide switches seen from the pin side: left as bought with three long pins, right with one pin clipped flush and two folded flat


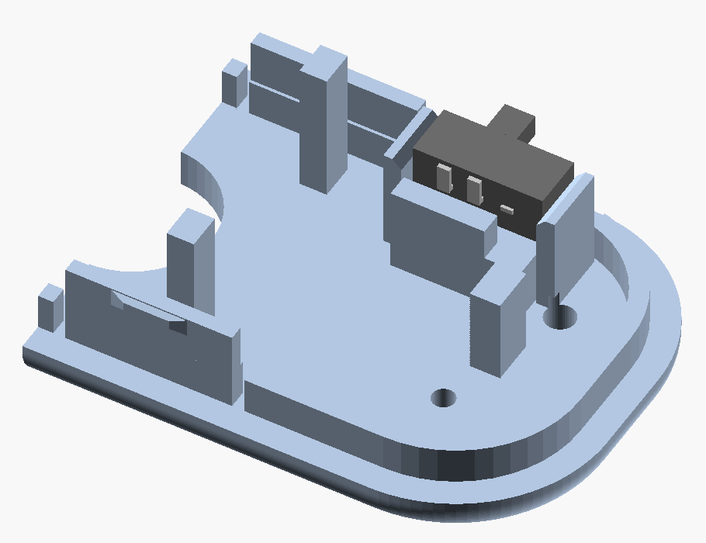
[picture p68: guide/img/psw_lid.png]
Lid face down with the prepped slide switch sitting flat in its cradle between the two end walls


- Push the handle to one end. With the meter, find which end pin beeps to the middle pin. Mark that end of the body: it is the ON end, and it faces the buttons in the case. The other end pin is unused.
- Clip the unused pin flush with the body. Clip the middle pin and the ON pin to about 2 mm.
- Bend each of those two pins 90° so it lies flat against the bottom of the switch. Grip the pin with flat pliers right where it leaves the body and push the tip over the jaw, so the pliers take the strain, not the plastic. Bend both toward the same long side.
- Tin both pins. Solder a 50 mm wire to the ON pin, leaving from the pin tip, not sticking out sideways. The middle pin gets the battery red in the next step. Kapton over the joints.
- Check: the switch sits flat in the lid's cradle between the two end walls, nothing touching the long wall on the pin side.

### Battery

- Cut the red lead behind the connector, strip 2 mm, solder it to the slide switch's middle pin. Kapton over the joint.
- Only then cut the black lead and strip it. Tape the end until the next step.

### XIAO

- NEXT wire to D0, PREV wire to D1. Keep the D1 joint low: the slide switch sits 2 mm above it.
- Ground wire to GND, the second pad on the 5V side.
- Slide switch ON wire to BAT+ and battery black to BAT− on the underside. Run both wires out toward the end away from USB, flat against the board. Kapton over both joints.

The board rests on 2 mm rails along its long edges, so the underside joints and Kapton must stay under 1.5 mm tall and between the rails.

## Bench test

- Slide switch to ON. The remote reconnects to the e-reader within a few seconds.
- NEXT turns forward, PREV turns back.
- Plug in USB with the switch ON: the charge LED lights.
- Switch to OFF: the e-reader shows it disconnected and the buttons do nothing.

If OFF does not cut power, the ON wire is on the wrong end pin. Move it to the other end pin.

## Assemble

1. Battery and board. Switch to OFF. Lay the battery flat in the bay at the far end, leads toward the board. Set the XIAO on its rails, components up, USB-C into the end opening. It is held by the end stops and the rounded corners.
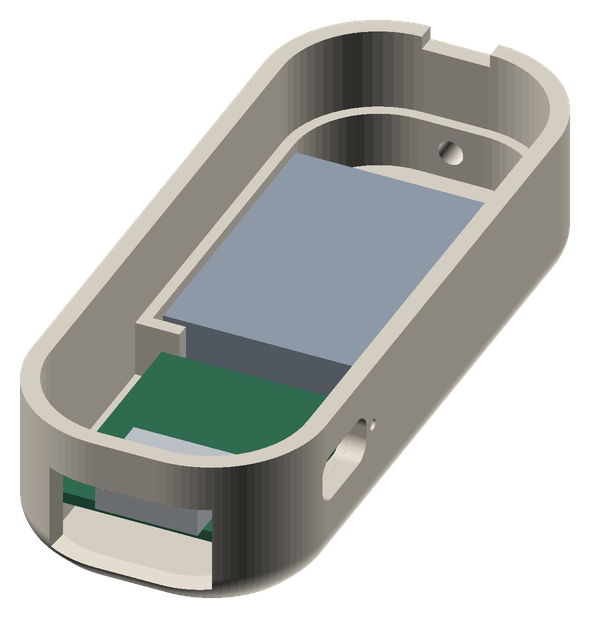
[picture p69: guide/img/base_pcb.png]
Base with battery in the far bay and the XIAO on its rails
  
2. Knob and slide switch. From inside, push the knob's tile out through the side window and slide it to the USB end of the window. Set the switch handle to OFF, then press the handle into the knob's pocket with the ON end toward the buttons and the bent pins pointing down at the board. The switch hangs on the knob until the lid goes on.
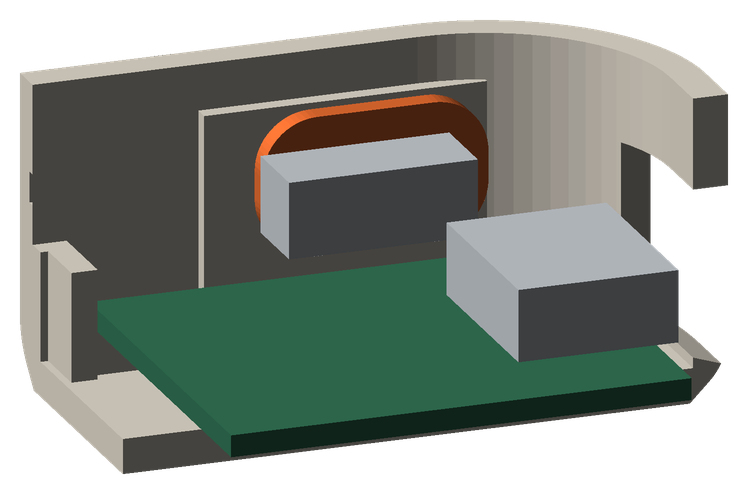
[picture p70: guide/img/knob_in.png]
Cut-away from inside the base: knob flange behind the wall window, slide switch seated on it
  
3. Tray. Lower the tray onto the ledge around the battery. Its front edge rests on the board's end stops. Tuck the wires down along the sides, clear of the snap-finger slots in the walls.
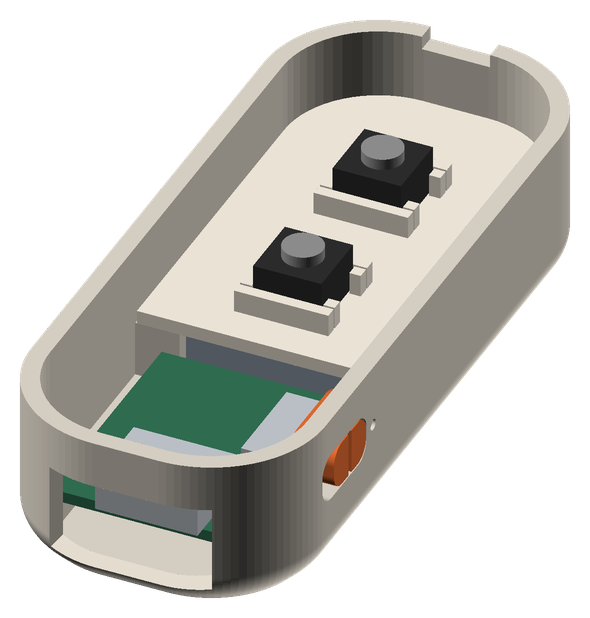
[picture p71: guide/img/tray_in.png]
Base with tray installed over the battery, switches on top
  
4. Caps and lid. Put the lid face down on the bench and drop both caps into their windows, flange up. Turn the base over and lower it onto the lid. Check that the slide switch lines up between the two small walls on the lid, then press until all four fingers click.
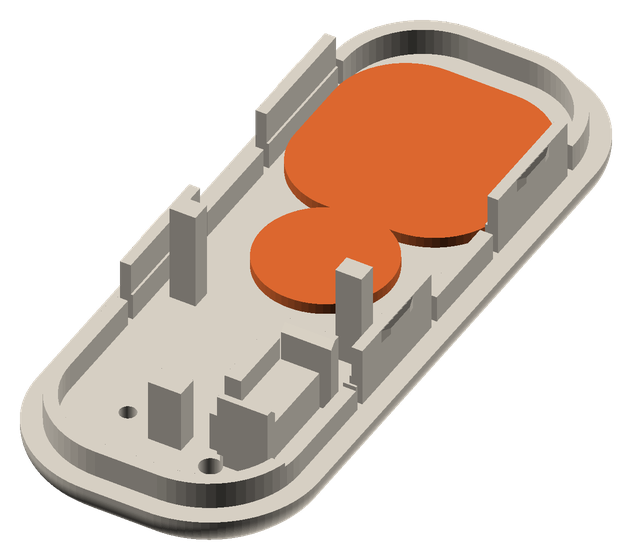
[picture p72: guide/img/lid_caps.png]
Lid face down with both caps sitting in their windows
  

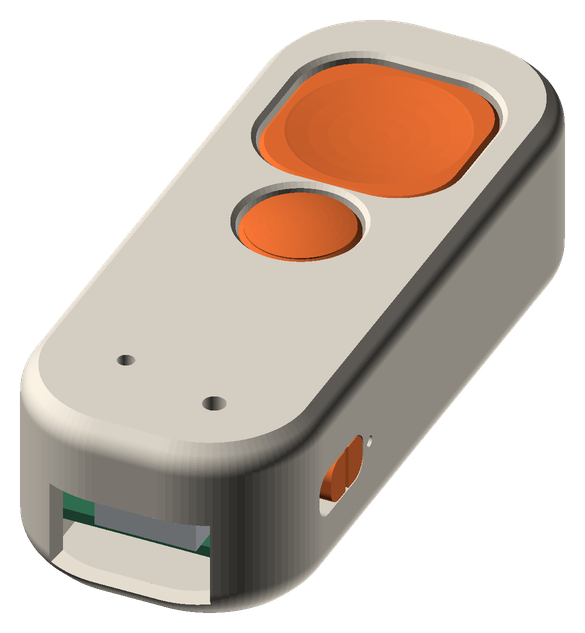
[picture p73: guide/img/done.png]
Finished remote


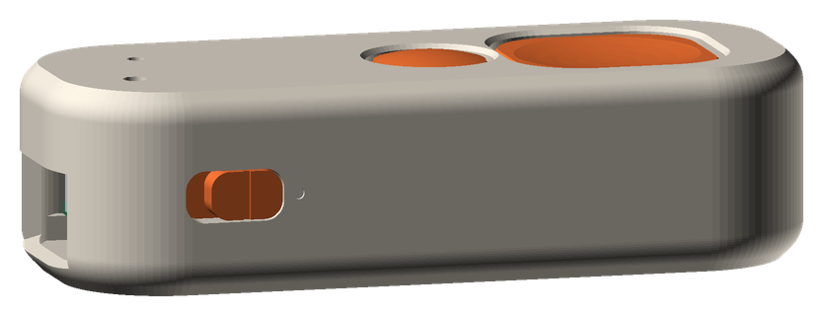
[picture p74: guide/img/side.png]
Side view with the power slider


## Use

Do | Result
Slider toward the buttons | On. Toward USB is off, with the battery fully disconnected.
Charge | Slider must be ON; it charges through the XIAO.
NEXT / PREV | Page Down / Page Up
Hold both, 1–4 s | Button lock on or off
Hold both, 4 s or more, on USB | Bootloader drive, for new firmware
Hold PREV 5 s | Soft power off; any press wakes it
Paperclip in the pinhole by USB, twice | Bootloader, if the buttons can't
Open the case | Fingernail in the notch at the far end

## Fixes

Change the param in case/params.scad, run ./render.sh kobo, reprint the one part.

Symptom | Change
Cap binds in its window | fit 0.25 → 0.35
Cap rattles or sits low | preload -0.1 → 0
Button stays pressed | preload -0.1 → -0.2, and re-measure sw_h
Lid too tight to snap | snap_bump 0.3 → 0.2
Lid loose | snap_bump 0.3 → 0.4
Tact switch loose in its pocket | pocket_fit 0.15 → 0.1
Knob stiff in the window | knob_fit 0.15 → 0.25
Knob loose on the handle | knob_pocket_fit 0.1 → 0.05, or a drop of CA
USB plug won't seat | usb_plug, usb_flare
Pairing misbehaves | Flash settings_reset.uf2, then read_remote.uf2, then re-pair
