ianhyzy/read-remote/(commit log)

2026-10-18 Layout draft + first full model: base, snap-fit lid, two captured plungers
    [base.stl, lid.stl, page_turner.scad, params.scad, plunger_next.stl, plunger_prev.stl]
2026-10-18 Big recessed caps filling the far half of the lid
    [base.stl, lid.stl, page_turner.scad, params.scad, plunger_next.stl, plunger_prev.stl]
2026-10-18 Seven button-layout variants, lanyard hole, research notes
    [base.stl, lid.stl, page_turner.scad, params.scad, plunger_next.stl, plunger_prev.stl]
2026-10-18 Pebble shell: asymmetric plan radii, filleted top/bottom edges, kobo layout default
    [base.stl, lid.stl, page_turner.scad, params.scad, plunger_next.stl, plunger_prev.stl]
2026-10-19 Symmetric pebble: r10 at both ends, PCB/battery set back to clear the corners
    [base.stl, lid.stl, page_turner.scad, params.scad]
2026-10-19 Avoid coplanar preview artefacts on rail clip
    [base.stl, page_turner.scad]
2026-10-19 USB opening: overmold-sized funnel with 45deg lead-in through base and lid
    [base.stl, lid.stl, page_turner.scad, params.scad]
2026-10-19 Re-layout: battery under drop-in switch tray, PCB on floor with lid pillars, snap fingers, chamfered windows, pry notch
    [base.stl, lid.stl, page_turner.scad, params.scad, plunger_next.stl, plunger_prev.stl, tray.stl]
2026-10-19 kobo NEXT cap: 16.6 mm rounded square, r5.5 corners
    [lid.stl, page_turner.scad, params.scad, plunger_next.stl, tray.stl]
2026-10-19 Fit coupon, LED light-pipe hole, print-in-place magnet pockets, cap_shift knob
    [base.stl, coupon_base.stl, coupon_lid.stl, coupon_tray.stl, lid.stl, page_turner.scad, params.scad, plunger_next.stl]
2026-10-19 Clamp cap_shift instead of asserting
    [page_turner.scad]
2026-10-19 Layout labels
    [page_turner.scad]
2026-10-19 Move case under case/, add ZMK firmware config and CI build
    [base.stl, coupon_base.stl, coupon_lid.stl, coupon_tray.stl, lid.stl, page_turner.scad, params.scad, plunger_next.stl]
2026-10-19 Pin ZMK to v0.3
2026-10-19 Hold both buttons 3 s to enter the UF2 bootloader
2026-10-19 Recess both caps 1 mm; both-buttons travel lock (1-4 s) and bootloader (4 s+)
    [params.scad, plunger_next.stl, plunger_prev.stl]
2026-10-19 Reversible cover (travel lid / grip), case grooves, lanyard raised, tray notch
    [base.stl, coupon_base.stl, coupon_tray.stl, cover.stl, page_turner.scad, params.scad, tray.stl]
2026-10-19 Cover parks under the palm end; USB notch in its skirt; magnets move into the cover
    [base.stl, coupon_base.stl, cover.stl, page_turner.scad, params.scad]
2026-10-19 Full-length reversible cover: flat underneath while reading, end skirts, grooves at both ends
    [base.stl, coupon_base.stl, cover.stl, page_turner.scad, params.scad]
2026-10-19 Hood: half cover for travel, parks flush on a lowered, inset palm half; lid split in two; magnets off
    [base.stl, coupon_base.stl, coupon_lid.stl, coupon_tray.stl, cover.stl, lid_back.stl, lid_front.stl, page_turner.scad]
2026-10-19 Concept renders: pebble, pen cap, sliding hood, channel slider
    [concepts.scad]
2026-10-19 Hard power cutoff: SS12D00G3 slide switch with a flush printed knob; back to the plain pebble, single lid, no hood
    [base.stl, concepts.scad, coupon_base.stl, coupon_lid.stl, coupon_tray.stl, cover.stl, knob.stl, lid.stl]
2026-10-19 Cap recess back to 0.5 mm: the power switch covers travel
    [params.scad, plunger_next.stl, plunger_prev.stl]
2026-10-29 Build guide with renders and wiring diagram; slide switch held by a lid cradle
    The knob flange collided with the switch boss in the base, and the base end
    walls were 0.35 mm fins. The base now only has the wall pad; the lid carries
    end walls with a lead-in alongside the existing block and leg.
    [base.stl, guide.scad, lid.stl, page_turner.scad]
2026-10-29 USB-end fit coupon: power-switch window, cradle and USB funnel
    [coupon_usb_base.stl, coupon_usb_lid.stl, guide.scad, page_turner.scad]
2026-10-31 Move the read_remote shield into a Zephyr module
    ZMK deprecated shields under config/boards. The repo is now a module
    (zephyr/module.yml, board_root: .) with the shield in boards/shields/,
    and the build workflow also triggers on boards/ and zephyr/ changes.
2026-10-31 Slide switch pin prep, window sag, PLA print settings
    - Model the slide switch pins (clipped, bent flat toward the PCB) and add
    psw_prep / psw_lid renders; section_psw now cuts through the middle pin
    - Guide: pin-prep diagram, renders and checklist; PLA, 0.12 mm, Smooth PEI
    - README assembly step 2 matches the guide
    - win_sag window tweak, kobo cap spacing, re-exported STLs and renders
    [base.stl, coupon_base.stl, coupon_lid.stl, coupon_tray.stl, coupon_usb_base.stl, coupon_usb_lid.stl, lid.stl, page_turner.scad]
